davidweber/my_lib/README.md

# my_lib
My kicad library of symbols, footprints, and 3dmodels.
