davidweber/my_lib/my_3dmodels/CC0603FPNPO9BN100.step

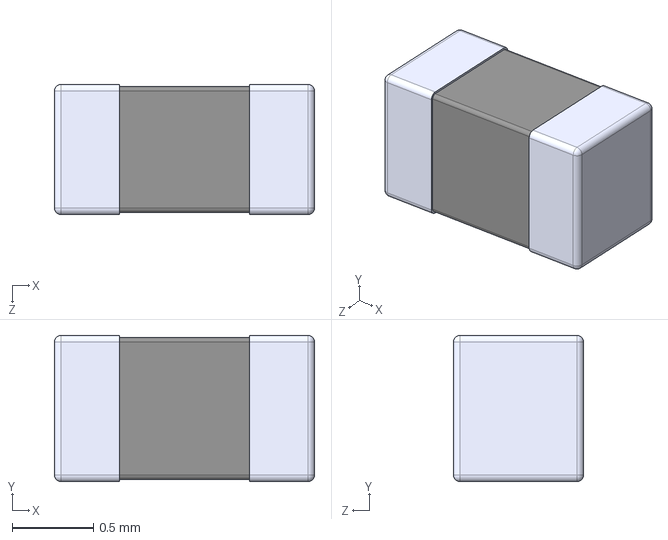
[picture p1: CAD file, 2026-08-25]
my_3dmodels/CC0603FPNPO9BN100.step
1.60 x 0.9 x 0.8 mm
