davidweber/my_lib/my_3dmodels/YC164-JR-0733RL.step

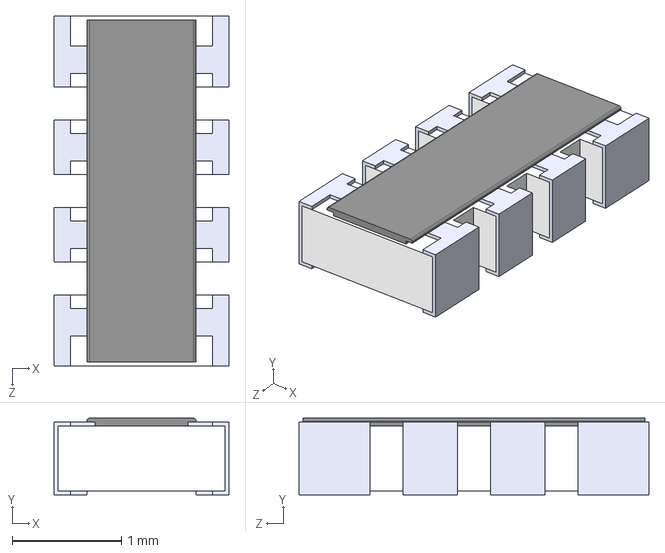
[picture p2: CAD file, 2026-08-25]
my_3dmodels/YC164-JR-0733RL.step
1.60 x 0.7 x 3.20 mm
