davidweber/my_lib/my_3dmodels/SHT40-CD1B-R3.step

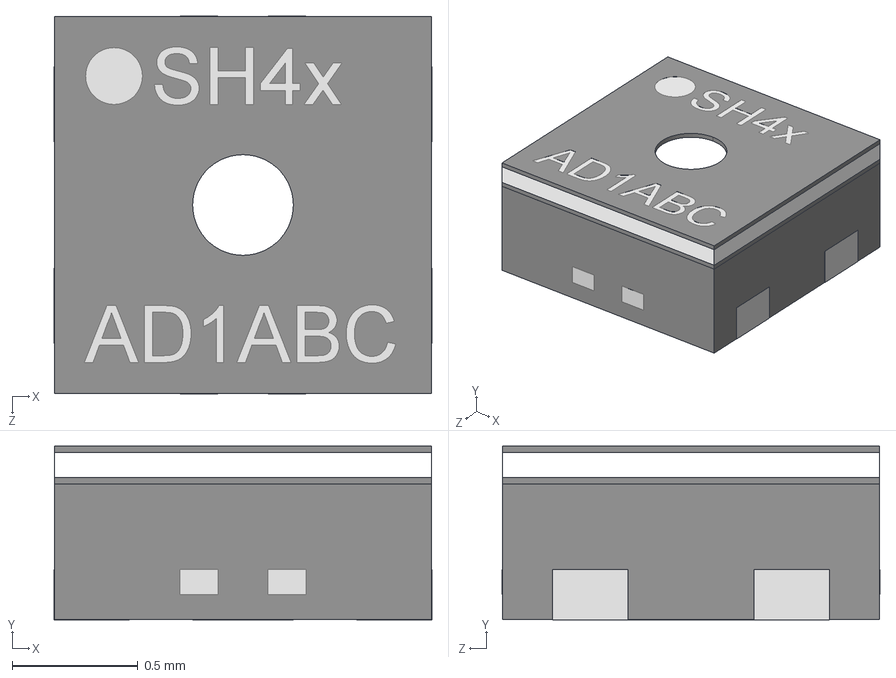
[picture p3: CAD file, 2026-08-25]
my_3dmodels/SHT40-CD1B-R3.step
1.50 x 0.691 x 1.50 mm
