davidweber/my_lib/my_3dmodels/ADS131M08IPBS.step

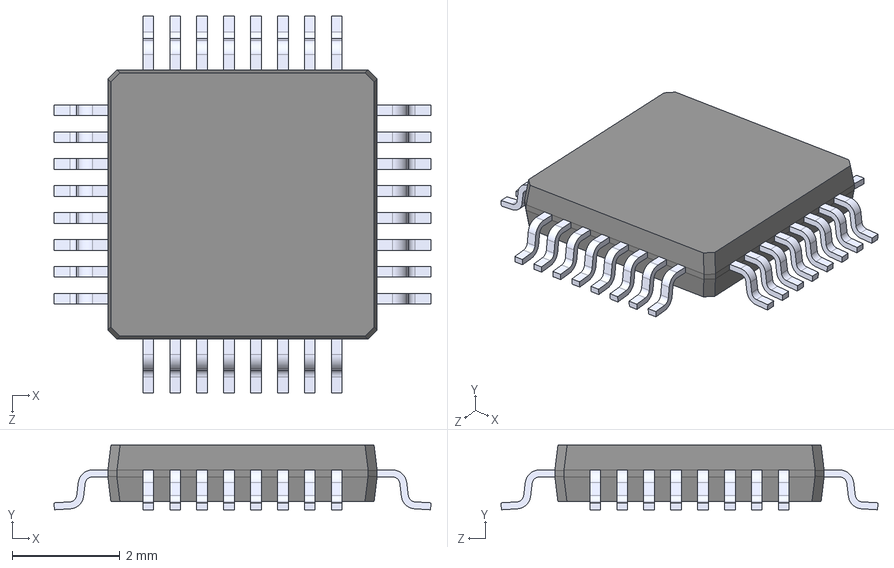
[picture p4: CAD file, 2026-08-18]
my_3dmodels/ADS131M08IPBS.step
7.00 x 1.20 x 7.00 mm
