davidweber/my_lib/my_3dmodels/ASV-16.384MHZ-EJ-T.step

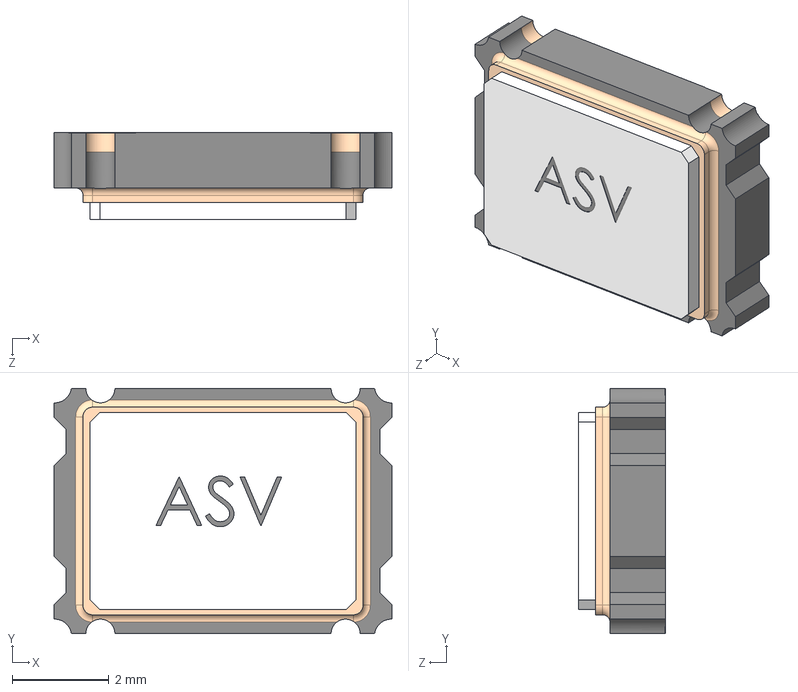
[picture p5: CAD file, 2026-08-18]
my_3dmodels/ASV-16.384MHZ-EJ-T.step
7.00 x 5.08 x 1.80 mm
