davidweber/my_lib/my_3dmodels/SN74HCS365QWBQBRQ1.step

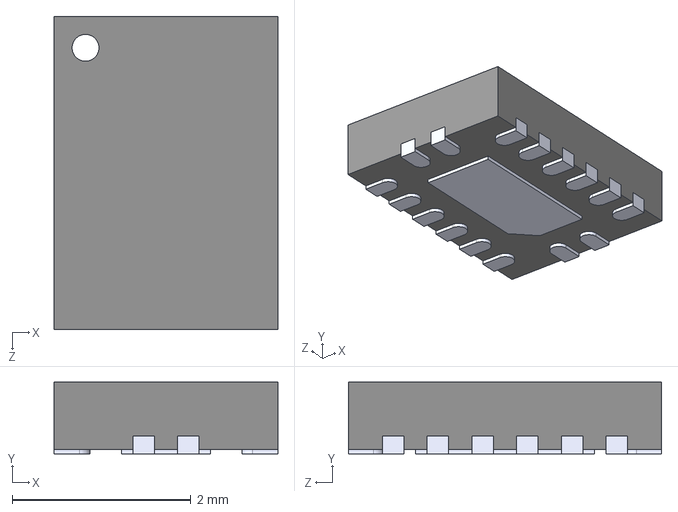
[picture p6: CAD file, 2026-08-18]
my_3dmodels/SN74HCS365QWBQBRQ1.step
2.50 x 0.8 x 3.50 mm
