davidweber/my_lib/my_3dmodels/YC164-FR-071KL.step

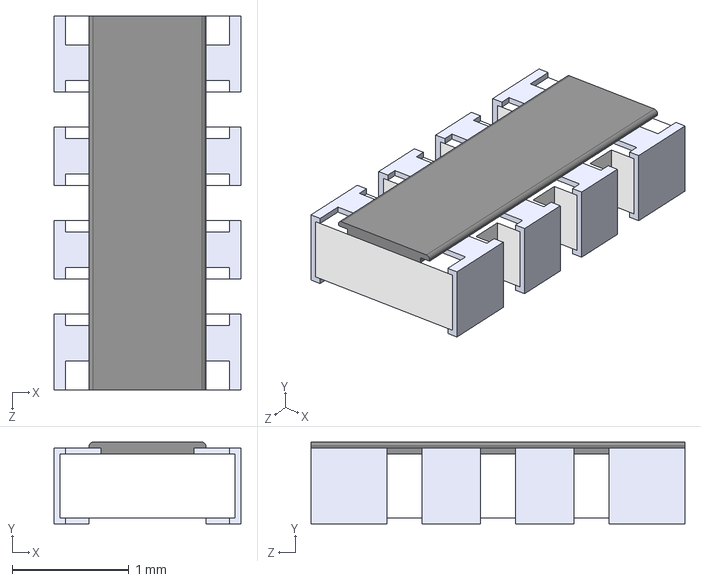
[picture p7: CAD file, 2026-08-18]
my_3dmodels/YC164-FR-071KL.step
1.60 x 0.7 x 3.20 mm
