davidweber/my_lib/my_3dmodels/ABM8-16.384MHZ-10-1-U-T.step

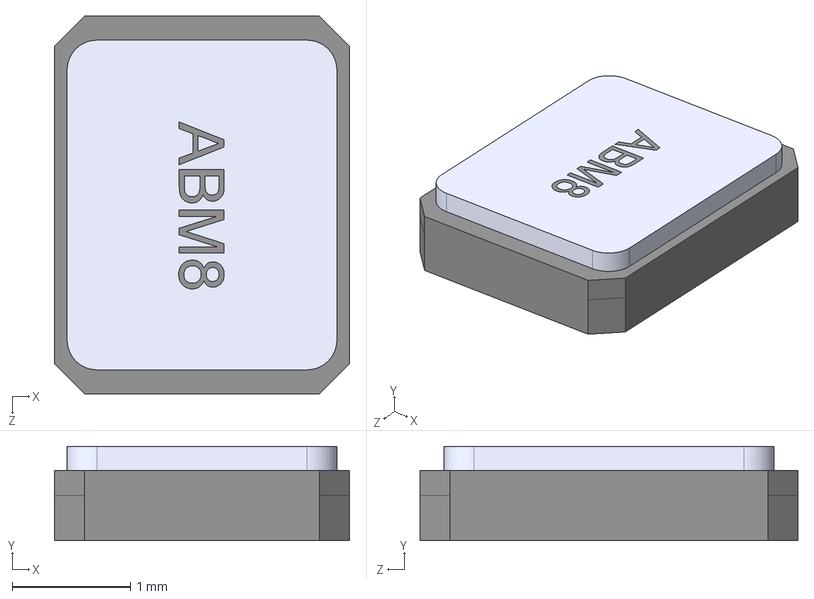
[picture p8: CAD file, 2026-08-18]
my_3dmodels/ABM8-16.384MHZ-10-1-U-T.step
2.50 x 0.8 x 3.20 mm
