davidweber/my_lib/my_3dmodels/YC124-FR-071KL.step

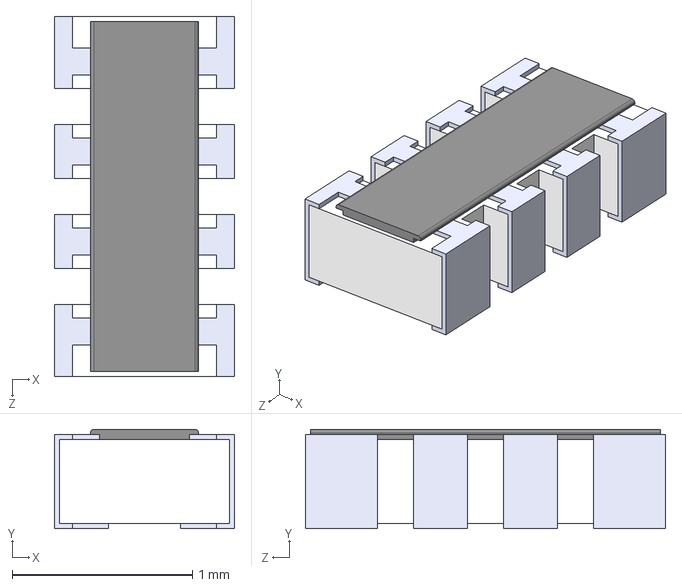
[picture p9: CAD file, 2026-08-18]
my_3dmodels/YC124-FR-071KL.step
1.00 x 0.55 x 2.00 mm
