davidweber/my_lib/my_3dmodels/ESP32-S3-MINI-1-N8.step

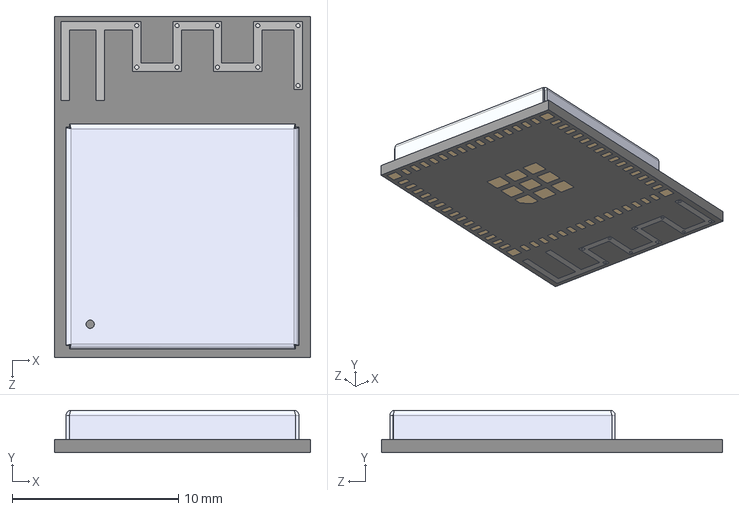
[picture p10: CAD file, 2026-05-01]
my_3dmodels/ESP32-S3-MINI-1-N8.step
15.4 x 2.55 x 20.5 mm
