davidweber/my_lib/my_3dmodels/ASDMB-50.000MHZ-XY-T.step

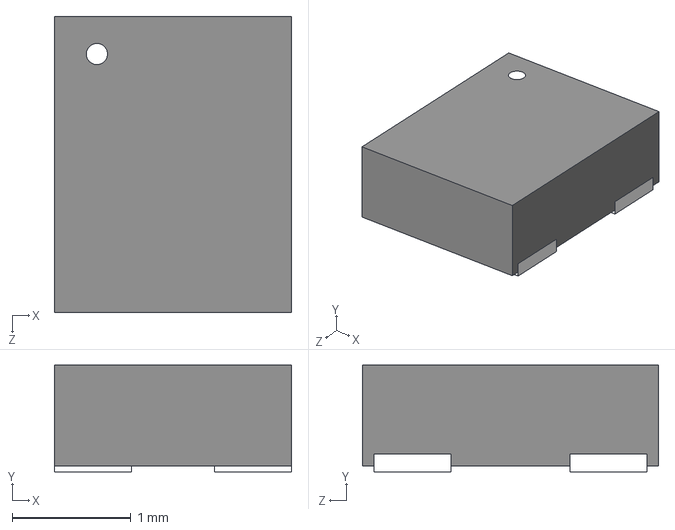
[picture p11: CAD file, 2026-04-23]
my_3dmodels/ASDMB-50.000MHZ-XY-T.step
2.00 x 0.9 x 2.50 mm
