davidweber/my_lib/my_3dmodels/L8BE-1G1T-BFH.step

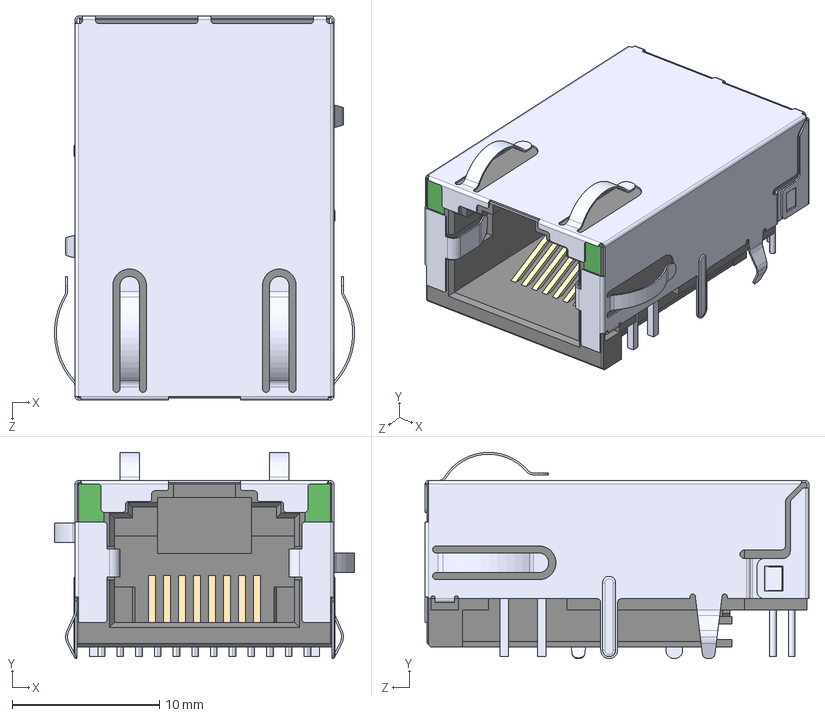
[picture p12: CAD file, 2026-04-10]
my_3dmodels/L8BE-1G1T-BFH.step
20.4 x 14.0 x 26.1 mm
