davidweber/my_lib/my_3dmodels/CONMHF1-SMD-G-T.step

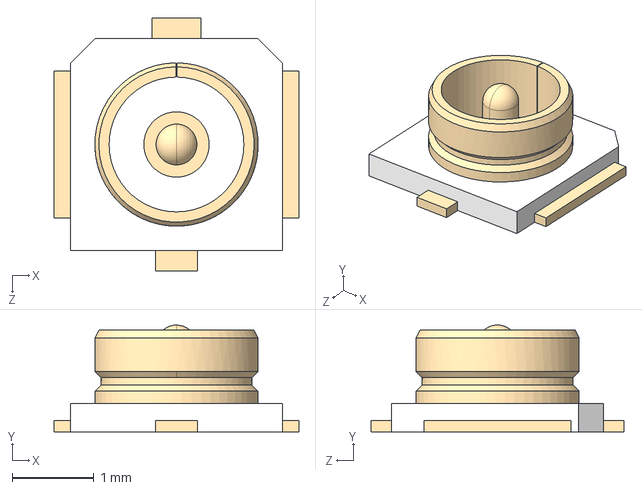
[picture p13: CAD file, 2026-04-10]
my_3dmodels/CONMHF1-SMD-G-T.step
3.00 x 1.31 x 3.10 mm
