davidweber/my_lib/my_3dmodels/MBRD660CTG.STEP

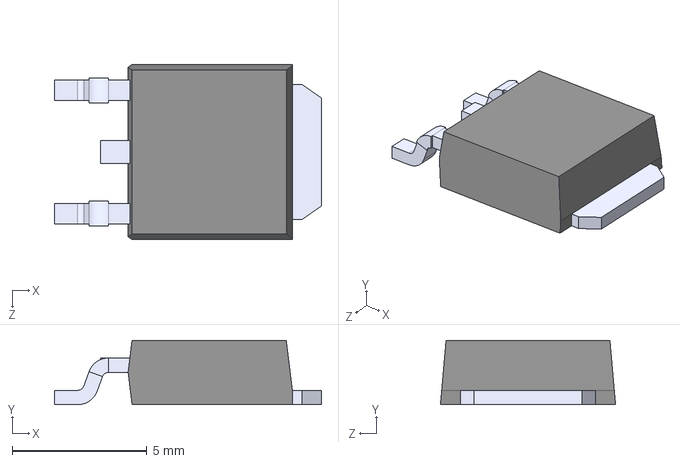
[picture p14: CAD file, 2026-03-04]
my_3dmodels/MBRD660CTG.STEP
9.91 x 2.39 x 6.50 mm
