davidweber/my_lib/my_3dmodels/TPD4E05U06DQAR.step

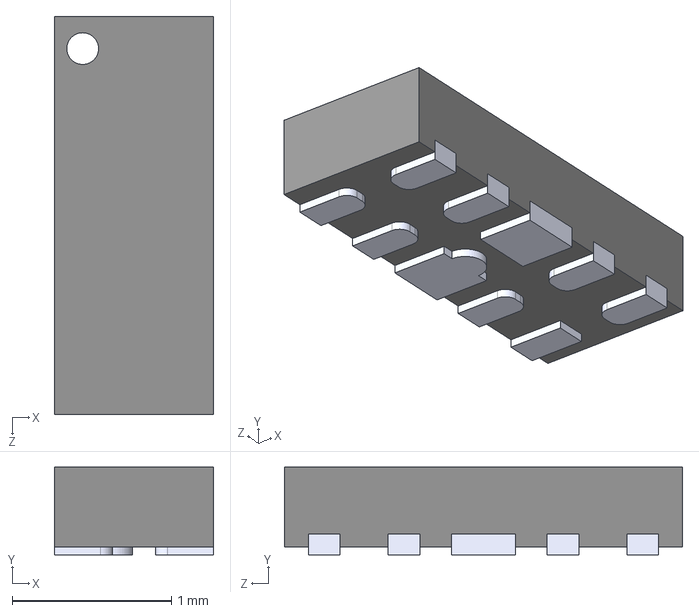
[picture p15: CAD file, 2026-02-11]
my_3dmodels/TPD4E05U06DQAR.step
1.00 x 0.55 x 2.50 mm
