davidweber/my_lib/my_3dmodels/MM8030-2610RK0.step

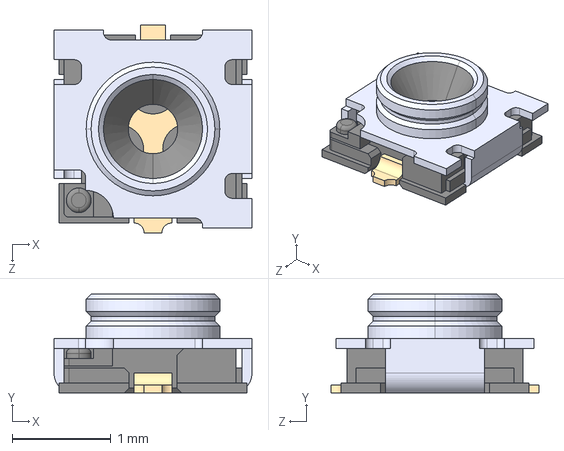
[picture p16: CAD file, 2026-02-11]
my_3dmodels/MM8030-2610RK0.step
2.00 x 1.00 x 2.10 mm
