davidweber/my_lib/my_3dmodels/SS36.step

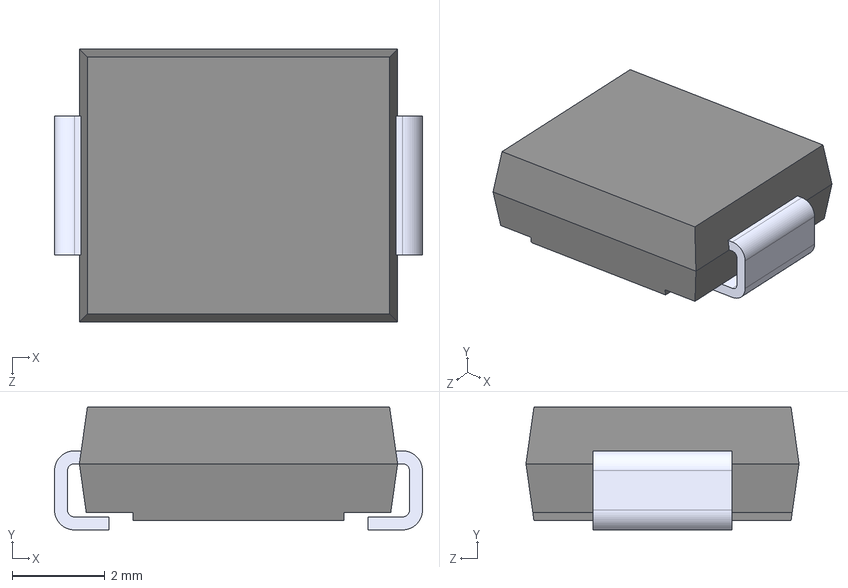
[picture p17: CAD file, 2026-02-11]
my_3dmodels/SS36.step
7.95 x 2.65 x 5.90 mm
