davidweber/my_lib/my_3dmodels/45F750E.step

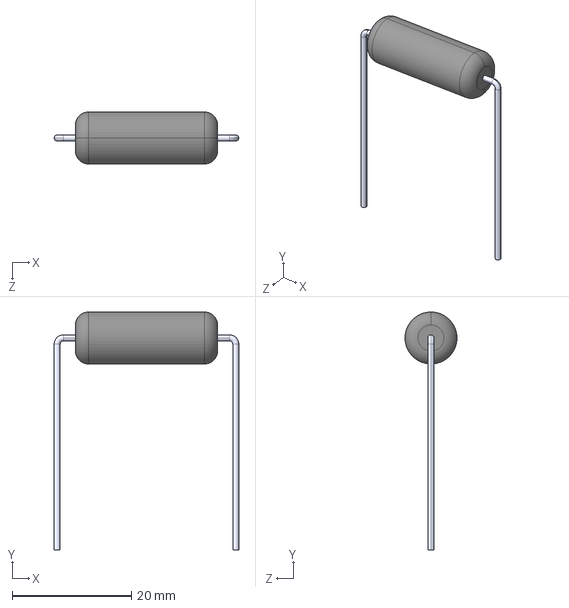
[picture p18: CAD file, 2025-10-25]
my_3dmodels/45F750E.step
30.9 x 39.8 x 8.70 mm
