davidweber/my_lib/my_3dmodels/3544.step

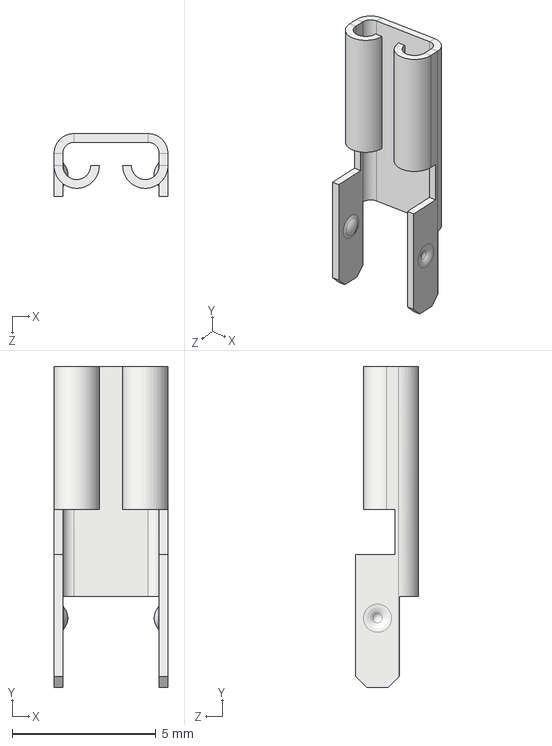
[picture p19: CAD file, 2025-10-25]
my_3dmodels/3544.step
3.96 x 11.2 x 2.18 mm
