davidweber/my_lib/my_3dmodels/B6B-PH-SM4-TB.STEP

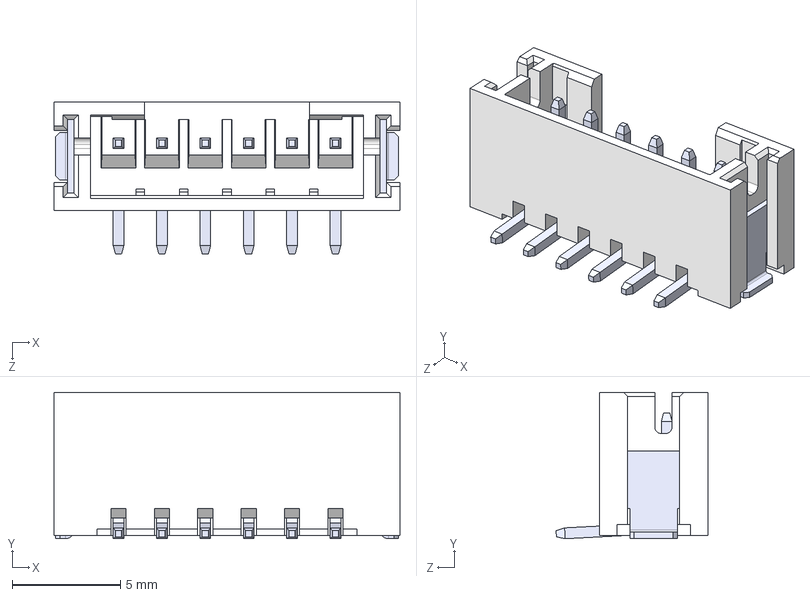
[picture p20: CAD file, 2025-10-25]
my_3dmodels/B6B-PH-SM4-TB.STEP
15.9 x 6.75 x 7.00 mm
BxB-PH-SM4 body_6
BxB-PH-SM4 tab x 2
BxB-PH-SM4 pin x 6
