davidweber/my_lib/my_3dmodels/WL-SMCW_0603.step

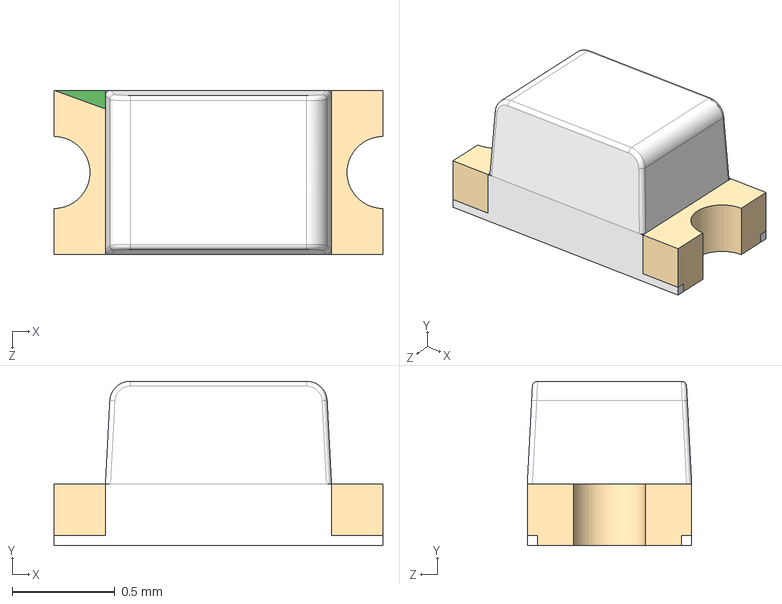
[picture p21: CAD file, 2025-08-18]
my_3dmodels/WL-SMCW_0603.step
1.60 x 0.8 x 0.8 mm
