davidweber/my_lib/my_3dmodels/MCP9700T-E_TT.STEP

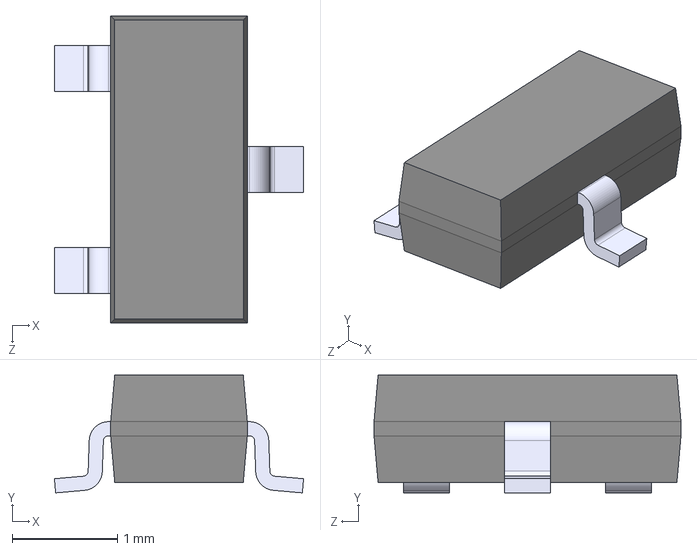
[picture p22: CAD file, 2025-08-11]
my_3dmodels/MCP9700T-E_TT.STEP
2.37 x 1.12 x 2.92 mm
