davidweber/my_lib/my_3dmodels/D2FC_F_7N_60M.step

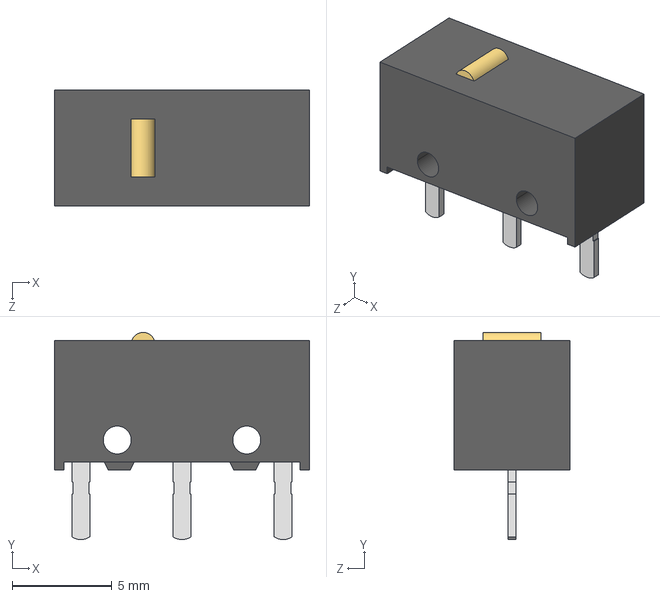
[picture p23: CAD file, 2025-07-26]
my_3dmodels/D2FC_F_7N_60M.step
12.8 x 10.4 x 5.80 mm
D2FC_F_7N_60M_BASE
D2FC_F_7N_60M_BUTTON
