davidweber/my_lib/my_3dmodels/S2B-PH-K-S_LF__SN_.step

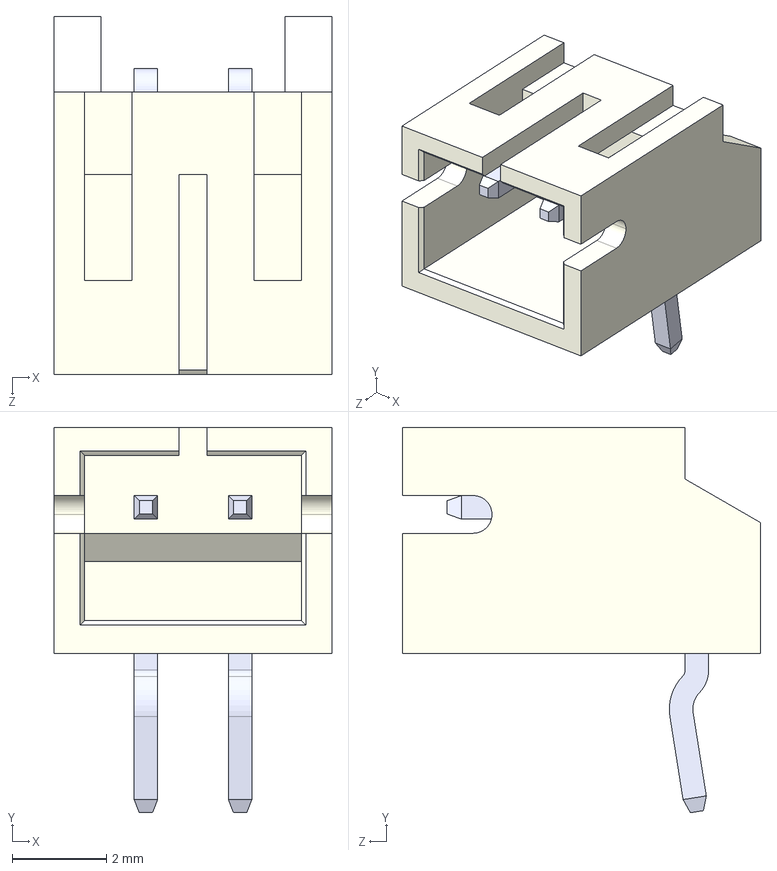
[picture p24: CAD file, 2025-07-26]
my_3dmodels/S2B-PH-K-S_LF__SN_.step
5.90 x 8.18 x 7.60 mm
