davidweber/my_lib/my_3dmodels/B6B-ZR-SM4-TF--3DModel-STEP-56544.STEP

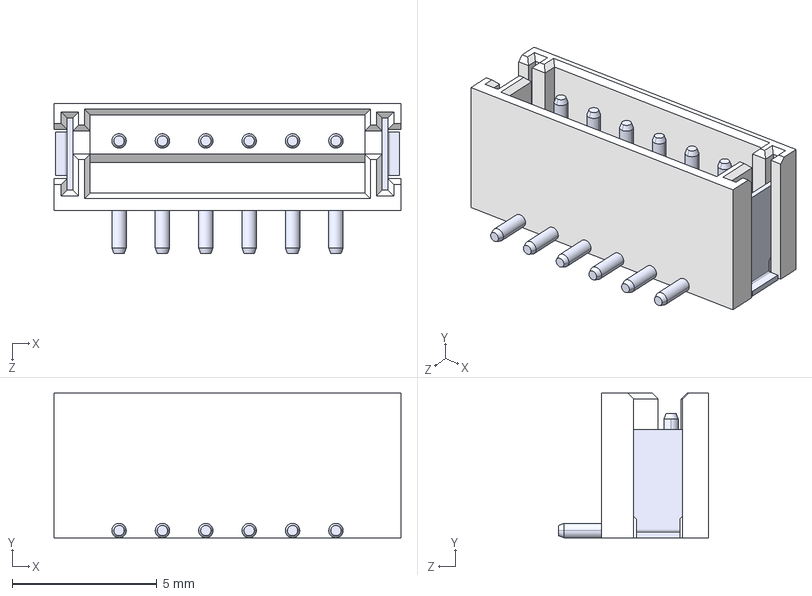
[picture p25: CAD file, 2025-07-26]
my_3dmodels/B6B-ZR-SM4-TF--3DModel-STEP-56544.STEP
12.0 x 5.00 x 5.20 mm
BxB-ZR-SM4_6
BxB-ZR-SM4 pins_6
