davidweber/my_lib/my_3dmodels/EM2-X-X-X.STEP

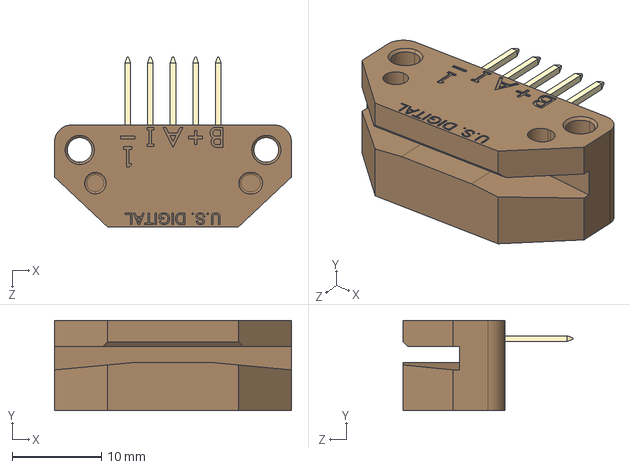
[picture p26: CAD file, 2025-07-26]
my_3dmodels/EM2-X-X-X.STEP
26.6 x 10.1 x 19.0 mm
