davidweber/my_lib/my_3dmodels/B5B-ZR-SM4-TF--3DModel-STEP-56544.STEP

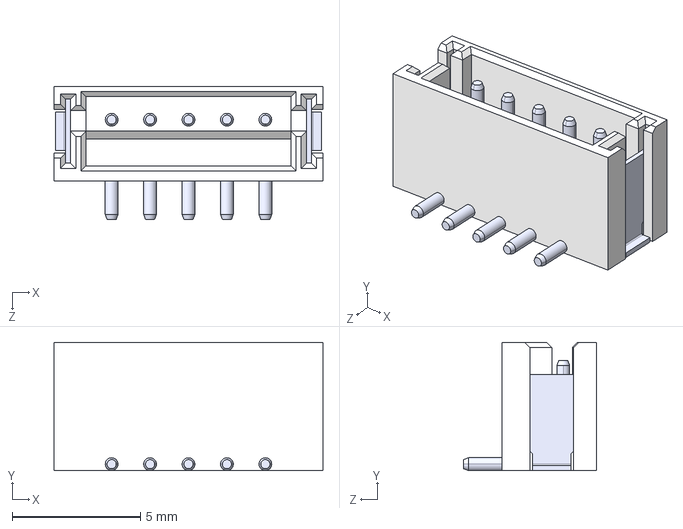
[picture p27: CAD file, 2025-07-26]
my_3dmodels/B5B-ZR-SM4-TF--3DModel-STEP-56544.STEP
10.5 x 5.00 x 5.20 mm
BxB-ZR-SM4_5
BxB-ZR-SM4 pins_5
