davidweber/my_lib/my_3dmodels/B2B-ZR-SM4-TF--3DModel-STEP-56544.STEP

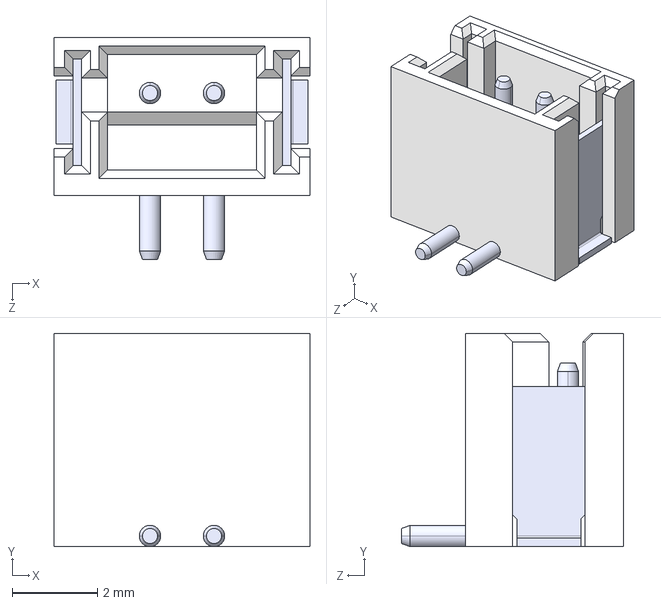
[picture p28: CAD file, 2025-07-26]
my_3dmodels/B2B-ZR-SM4-TF--3DModel-STEP-56544.STEP
6.00 x 5.00 x 5.20 mm
BxB-ZR-SM4_2
BxB-ZR-SM4 pins_2
