davidweber/my_lib/my_3dmodels/SOD523.step

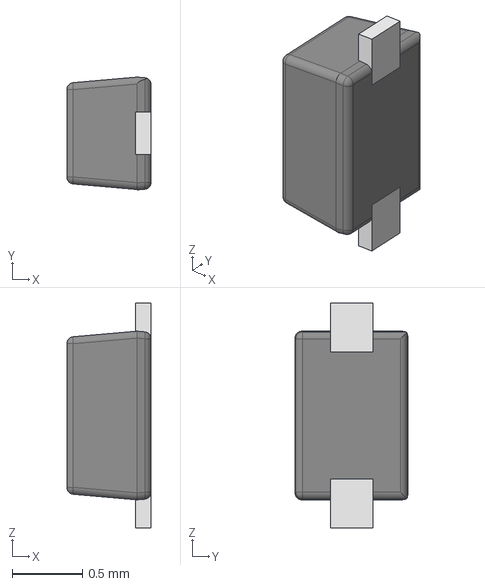
[picture p29: CAD file, 2025-03-31]
my_3dmodels/SOD523.step
0.6 x 0.803 x 1.60 mm
SOD523 LF
SOD523 compound
