davidweber/my_lib/my_3dmodels/DS01-254-S-01BE.step

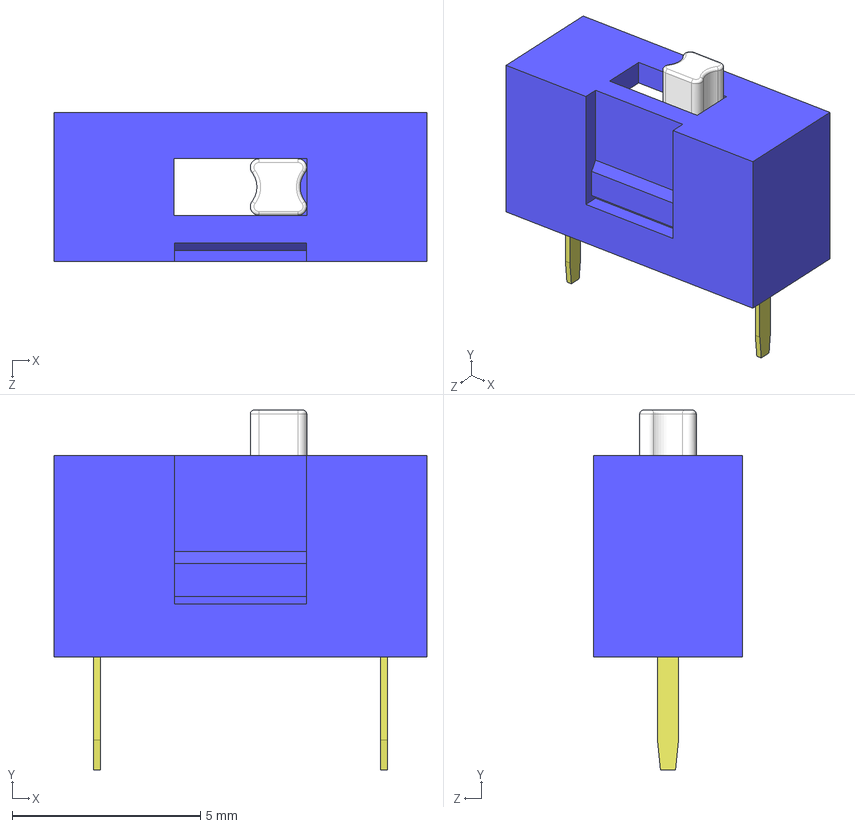
[picture p30: CAD file, 2024-12-07]
my_3dmodels/DS01-254-S-01BE.step
9.90 x 9.55 x 3.96 mm
