davidweber/my_lib/my_3dmodels/S4B-PH-K-S_LF__SN_.step

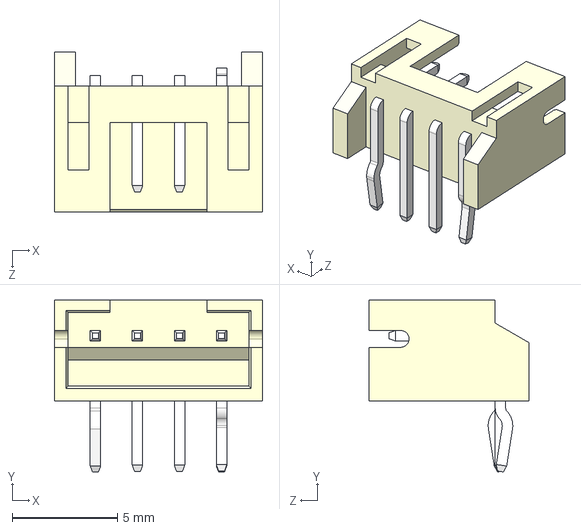
[picture p31: CAD file, 2024-11-26]
my_3dmodels/S4B-PH-K-S_LF__SN_.step
9.90 x 8.18 x 7.60 mm
