davidweber/my_lib/my_3dmodels/TFM-110-02-L-D-A-K-TR.step

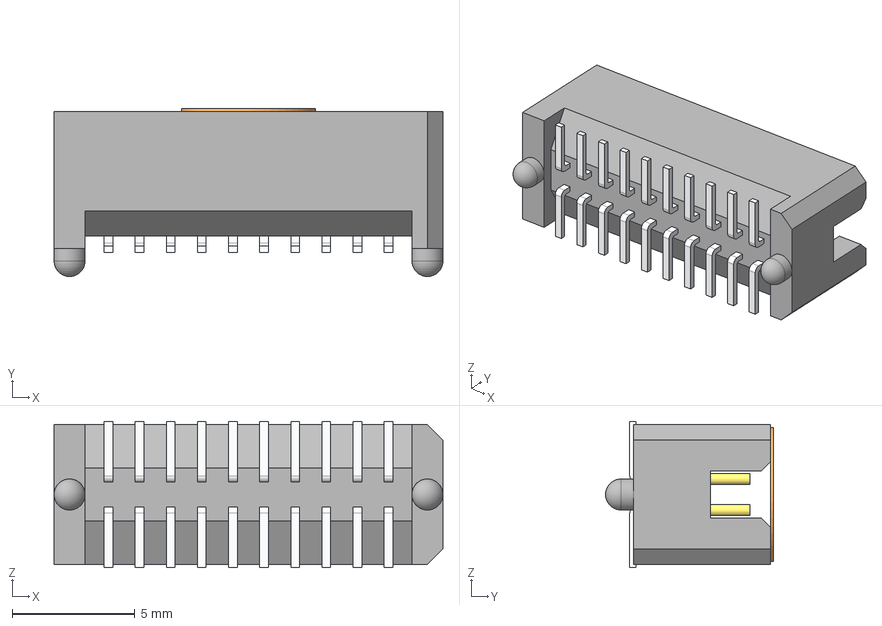
[picture p32: CAD file, 2024-11-12]
my_3dmodels/TFM-110-02-L-D-A-K-TR.step
15.9 x 6.86 x 5.97 mm
TFM-110-02-L-D-A_terminal
TFM-110-02-L-D-L_pins
TFM-110-02-L-D-L-2_pins
TFM-K_polyamide_pick
