davidweber/my_lib/my_3dmodels/RT9080-33GJ5.step

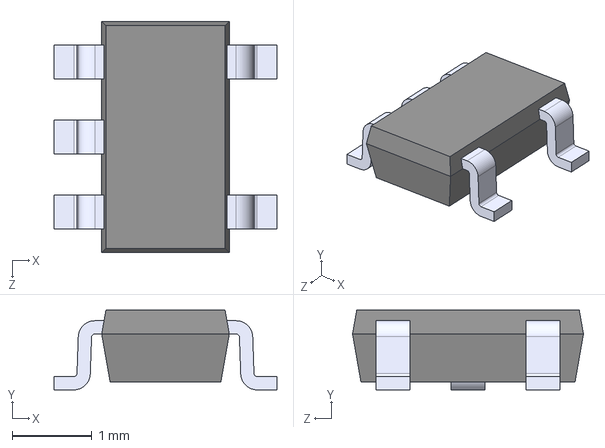
[picture p33: CAD file, 2024-11-12]
my_3dmodels/RT9080-33GJ5.step
2.80 x 1.00 x 2.90 mm
