davidweber/my_lib/my_3dmodels/SML-LXT0805IW-TR.step

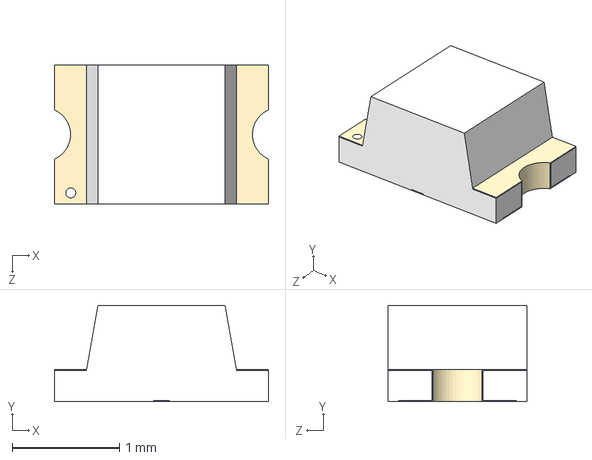
[picture p34: CAD file, 2024-11-12]
my_3dmodels/SML-LXT0805IW-TR.step
2.00 x 0.9 x 1.30 mm
