davidweber/my_lib/my_3dmodels/CUI_DEVICES_CMA-4544PF-W.step

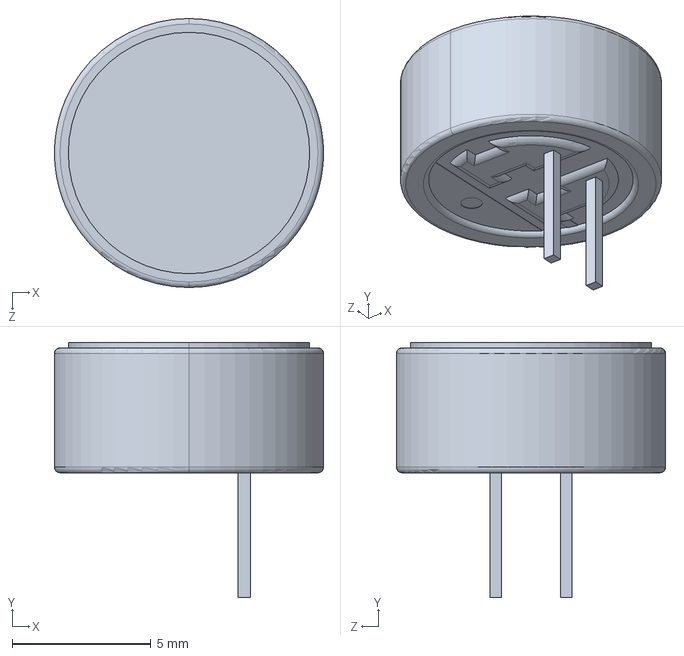
[picture p35: CAD file, 2024-11-12]
my_3dmodels/CUI_DEVICES_CMA-4544PF-W.step
9.70 x 9.20 x 9.70 mm
