davidweber/my_lib/my_3dmodels/smdCrystal.step

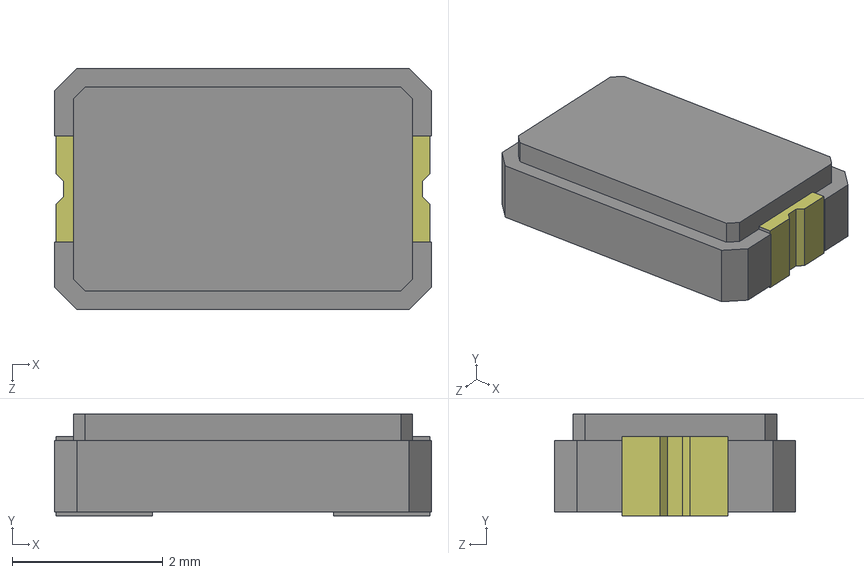
[picture p36: CAD file, 2024-11-12]
my_3dmodels/smdCrystal.step
5.00 x 1.35 x 3.20 mm
