davidweber/my_lib/my_3dmodels/PTS810.stp

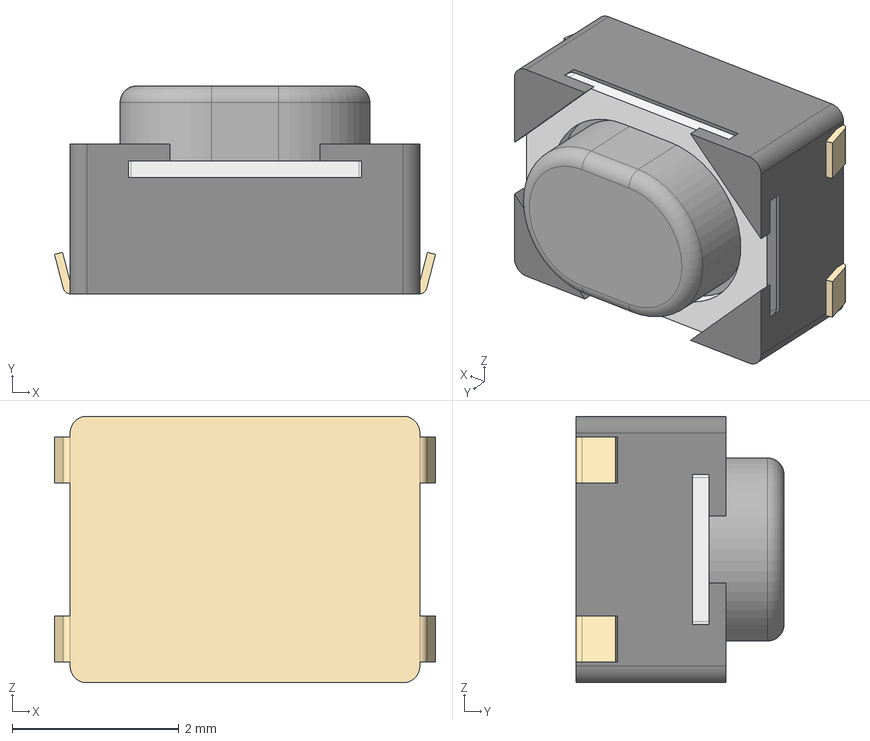
[picture p38: CAD file, 2024-11-12]
my_3dmodels/PTS810.stp
4.58 x 2.50 x 3.20 mm
