davidweber/my_lib/my_3dmodels/SAMTEC-LS2-120-01-X-D.step

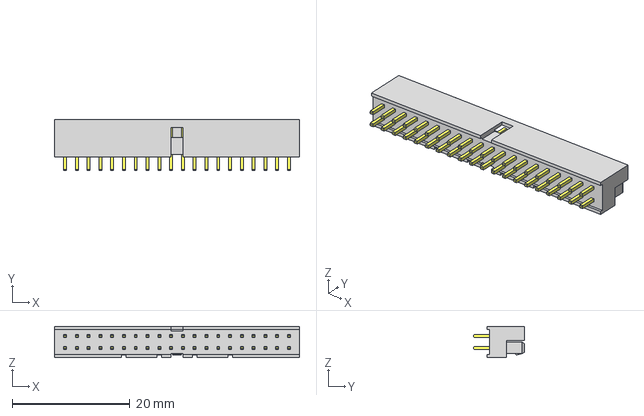
[picture p39: CAD file, 2024-11-12]
my_3dmodels/SAMTEC-LS2-120-01-X-D.step
41.5 x 8.64 x 5.27 mm
LS2-120-01-D_strip
T-1S13-20-01-D
