davidweber/my_lib/my_3dmodels/ERM5-020-02.0-L-DV-TR.step

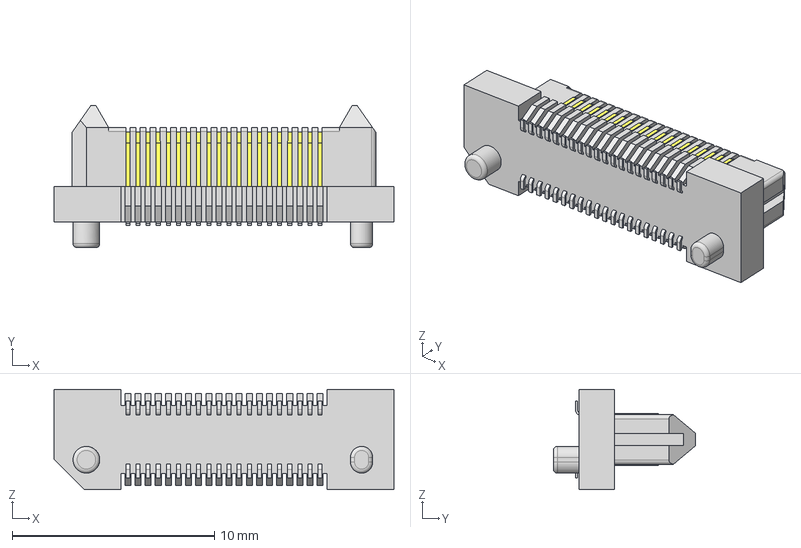
[picture p40: CAD file, 2024-11-12]
my_3dmodels/ERM5-020-02.0-L-DV-TR.step
16.8 x 7.04 x 4.95 mm
ERM5-020-02.0-DV_header
T-1M59-020-02.0
T-1M59-020-02.02
