davidweber/my_lib/my_3dmodels/xson-4.step

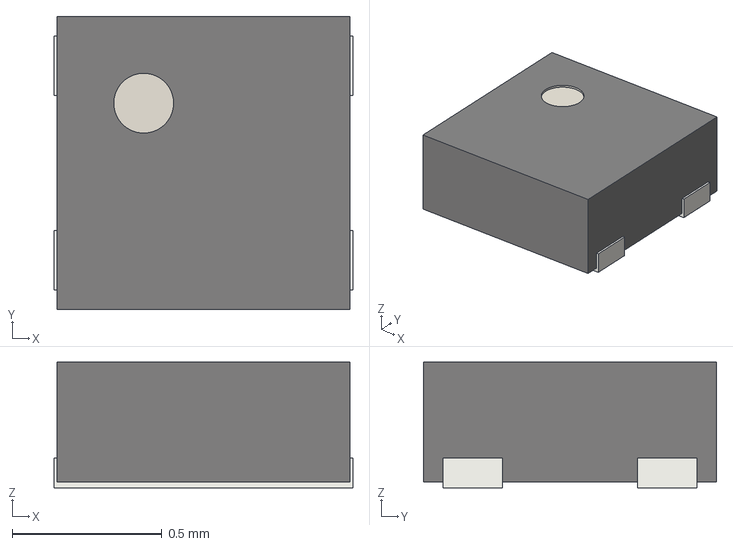
[picture p41: CAD file, 2024-11-12]
my_3dmodels/xson-4.step
1.00 x 0.98 x 0.42 mm
