davidweber/my_lib/my_3dmodels/1.8in TFT (Without Glass)- Tucked Cable.stp

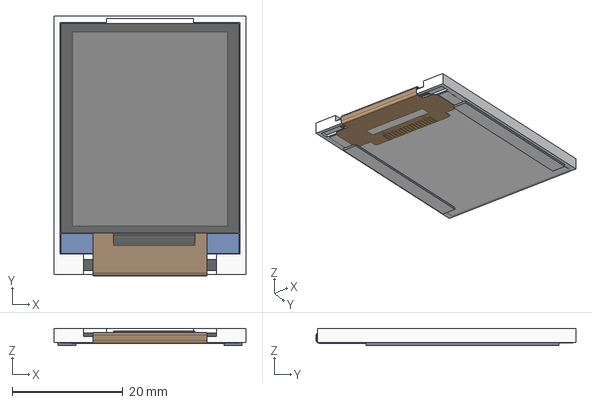
[picture p42: CAD file, 2024-11-12]
my_3dmodels/1.8in TFT (Without Glass)- Tucked Cable.stp
34.7 x 46.9 x 3.07 mm
