davidweber/my_lib/my_3dmodels/NX3L4051PW_118.step

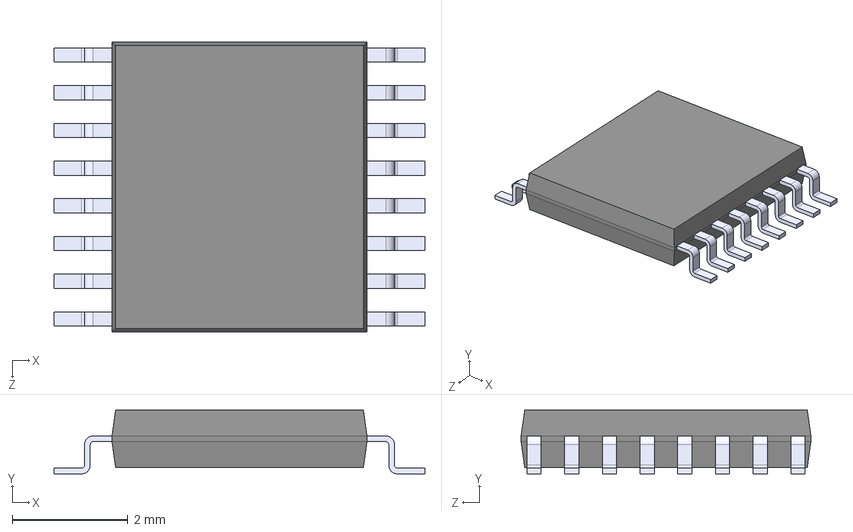
[picture p43: CAD file, 2024-11-12]
my_3dmodels/NX3L4051PW_118.step
6.40 x 1.10 x 5.00 mm
