davidweber/my_lib/my_3dmodels/BC020-04-A-0110-0160-L-G.step

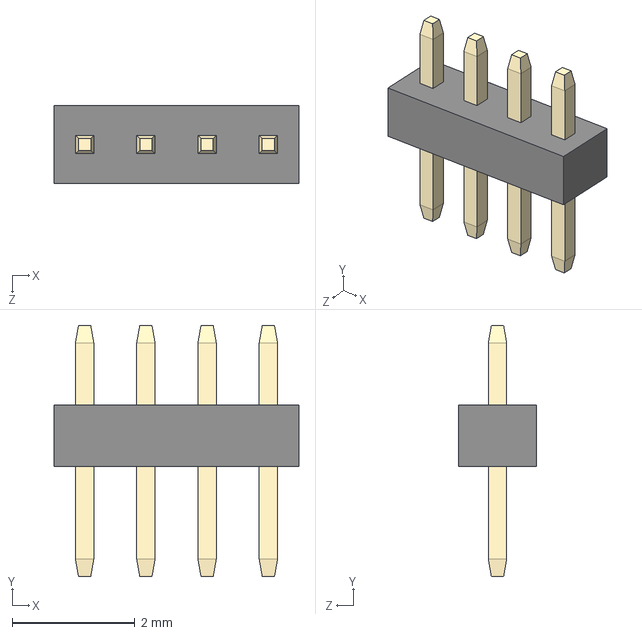
[picture p44: CAD file, 2024-11-12]
my_3dmodels/BC020-04-A-0110-0160-L-G.step
4.00 x 4.10 x 1.27 mm
Body^BC020-xxxx
pin^BC020-xxxx x 4
