davidweber/my_lib/my_3dmodels/CUI_DEVICES_TS02-66-60-BK-160-SCR-D.step

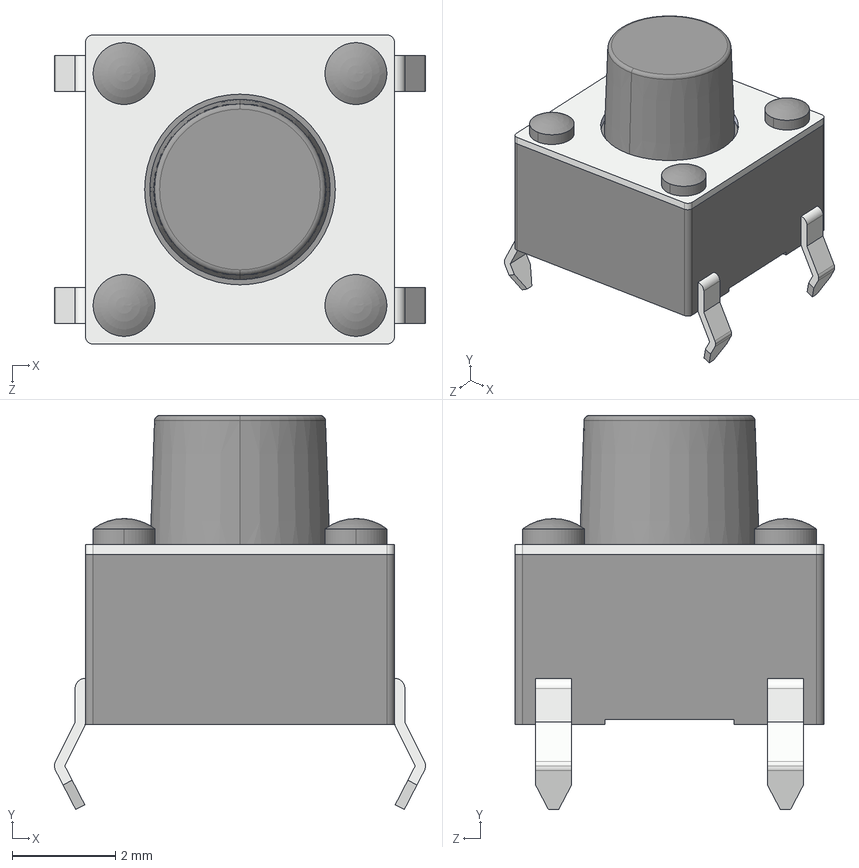
[picture p45: CAD file, 2024-11-12]
my_3dmodels/CUI_DEVICES_TS02-66-60-BK-160-SCR-D.step
7.20 x 7.65 x 6.00 mm
