davidweber/my_lib/my_3dmodels/OPA2354AQDGKRQ1.step

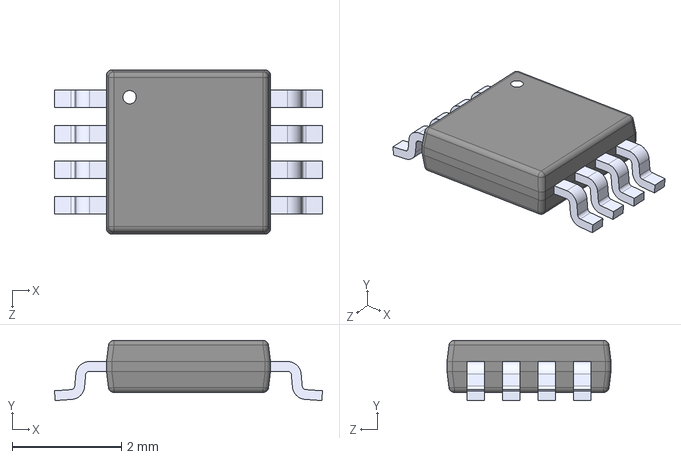
[picture p46: CAD file, 2024-11-12]
my_3dmodels/OPA2354AQDGKRQ1.step
4.90 x 1.10 x 3.00 mm
