davidweber/my_lib/my_3dmodels/FTSH-103-04-L-D.step

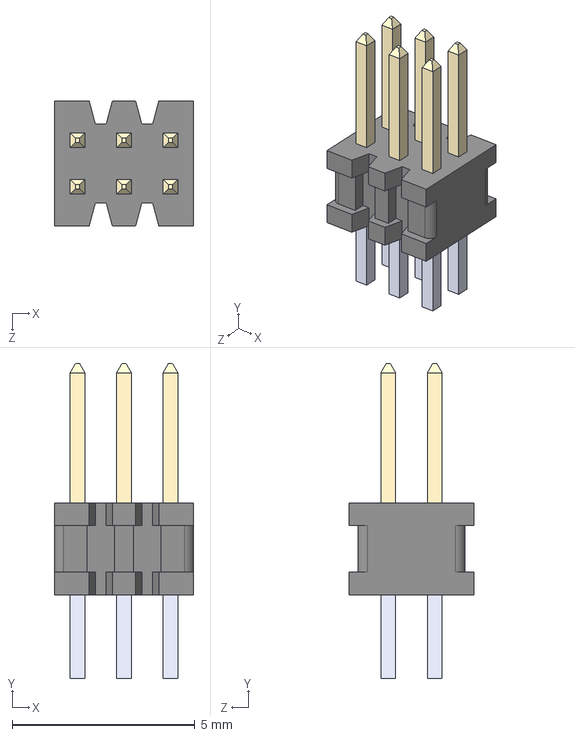
[picture p47: CAD file, 2024-11-12]
my_3dmodels/FTSH-103-04-L-D.step
3.81 x 8.61 x 3.43 mm
