davidweber/my_lib/my_3dmodels/ASFL1-25.000MHZ-L-T.step

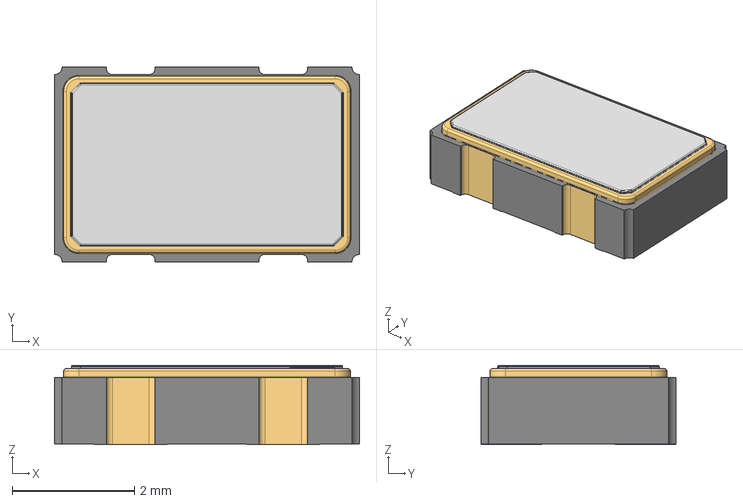
[picture p48: CAD file, 2024-11-12]
my_3dmodels/ASFL1-25.000MHZ-L-T.step
5.00 x 3.20 x 1.30 mm
