davidweber/my_lib/my_3dmodels/TSOT-23-5_RIT.step

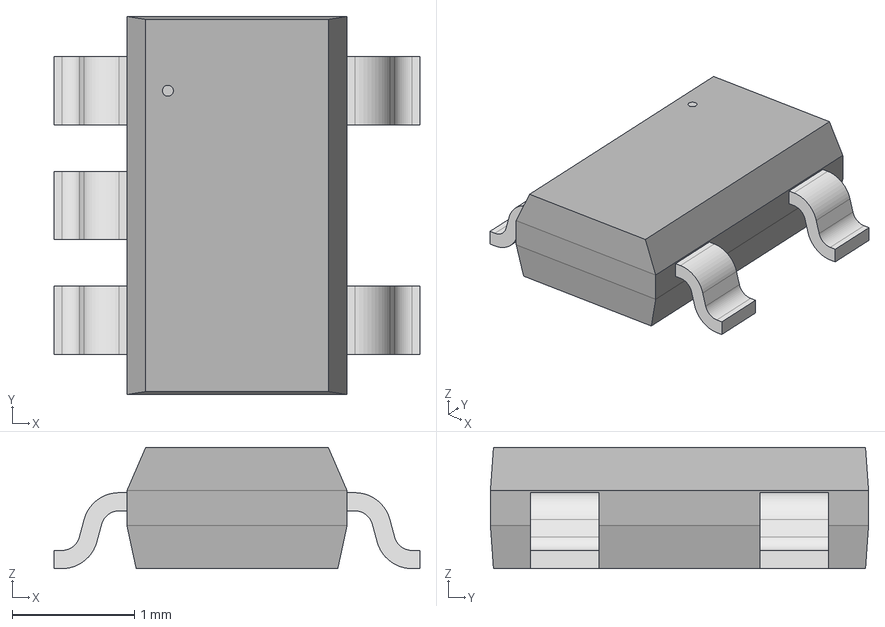
[picture p49: CAD file, 2024-11-12]
my_3dmodels/TSOT-23-5_RIT.step
3.00 x 3.10 x 0.993 mm
