davidweber/my_lib/my_3dmodels/74LVC125APW_AUJ.step

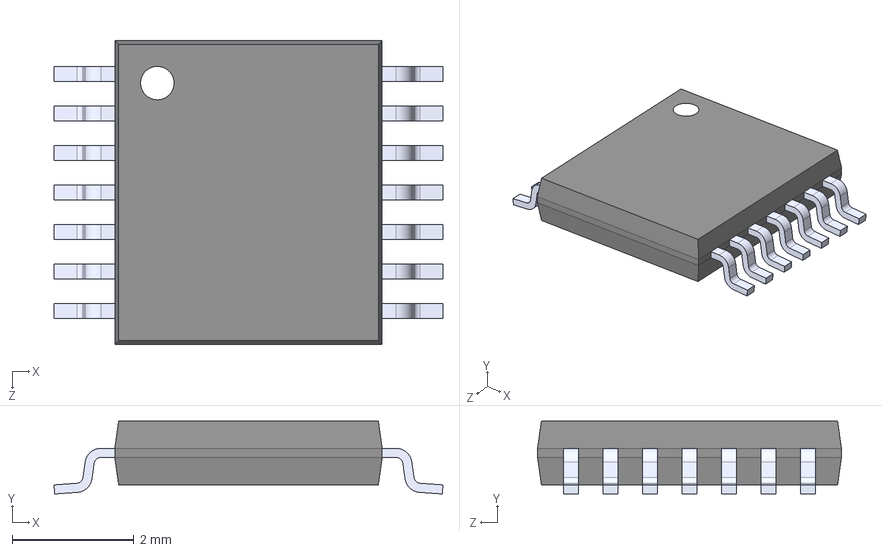
[picture p50: CAD file, 2024-11-12]
my_3dmodels/74LVC125APW_AUJ.step
6.40 x 1.20 x 5.00 mm
