davidweber/my_lib/my_3dmodels/KMR221GLFS.step

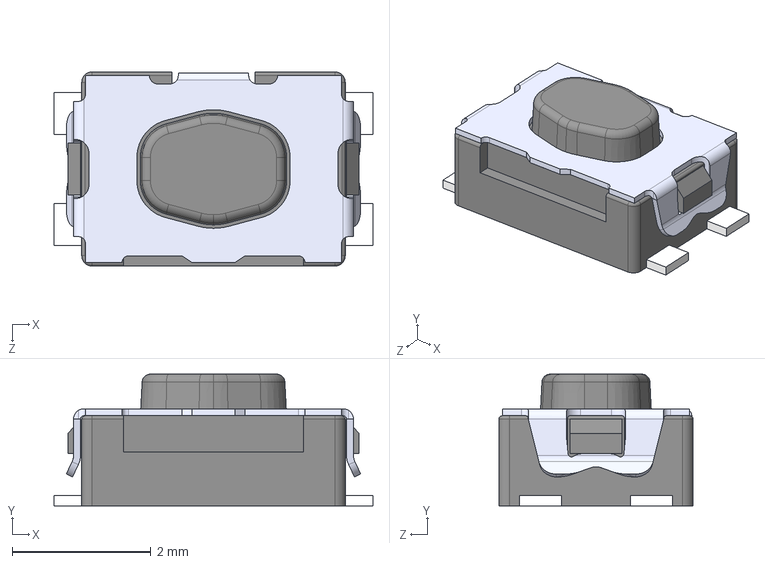
[picture p51: CAD file, 2024-11-12]
my_3dmodels/KMR221GLFS.step
4.60 x 1.90 x 2.80 mm
