davidweber/my_lib/my_3dmodels/3228_reverse_mount_led.step

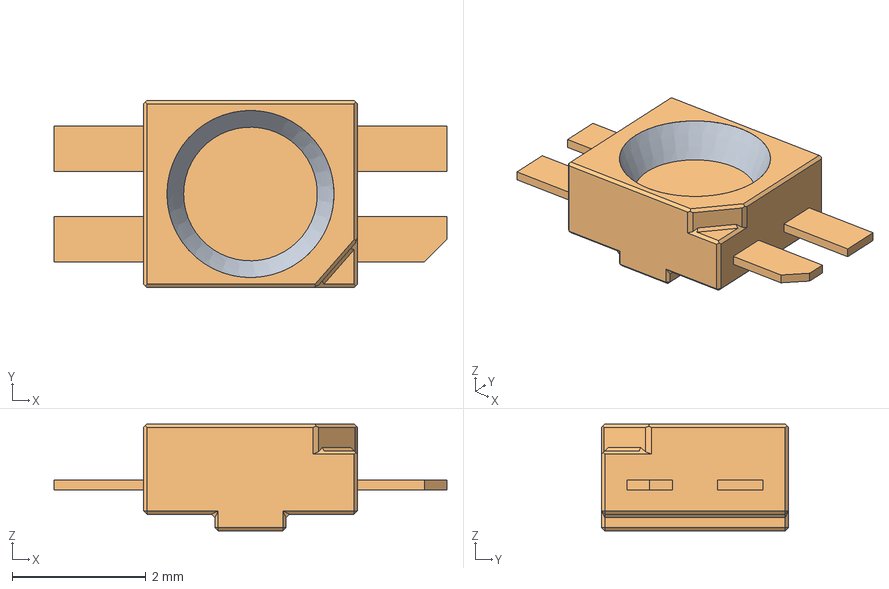
[picture p52: CAD file, 2024-11-12]
my_3dmodels/3228_reverse_mount_led.step
5.88 x 2.80 x 1.60 mm
