davidweber/my_lib/my_3dmodels/TP_SMD_S1751-46.step

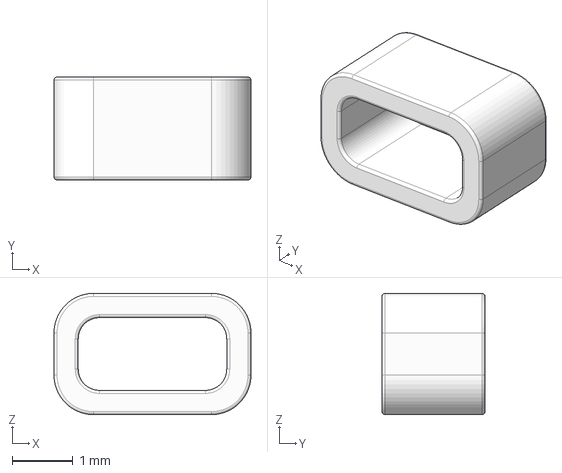
[picture p53: CAD file, 2024-11-12]
my_3dmodels/TP_SMD_S1751-46.step
3.25 x 1.70 x 2.00 mm
