davidweber/my_lib/my_3dmodels/LAN8742A-CZ-TR.step

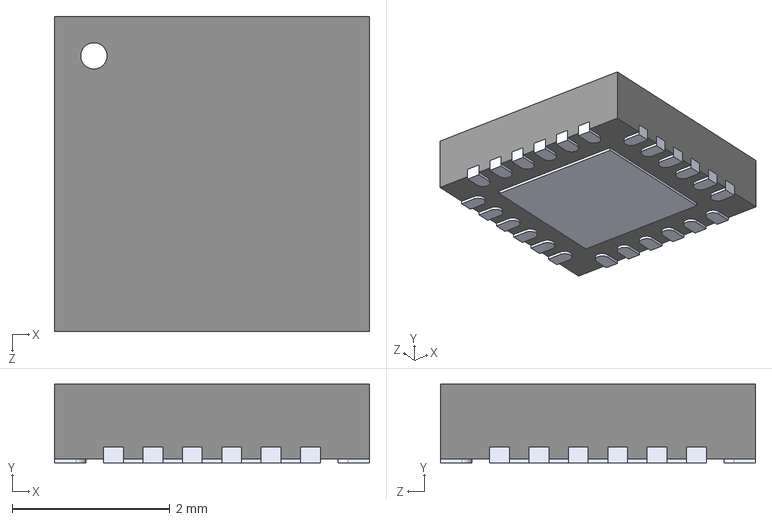
[picture p54: CAD file, 2024-11-12]
my_3dmodels/LAN8742A-CZ-TR.step
4.00 x 1.00 x 4.00 mm
