davidweber/my_lib/my_3dmodels/T-PBGA-24_6.0x8.0mm_Layout5x5_P1.0mm.step

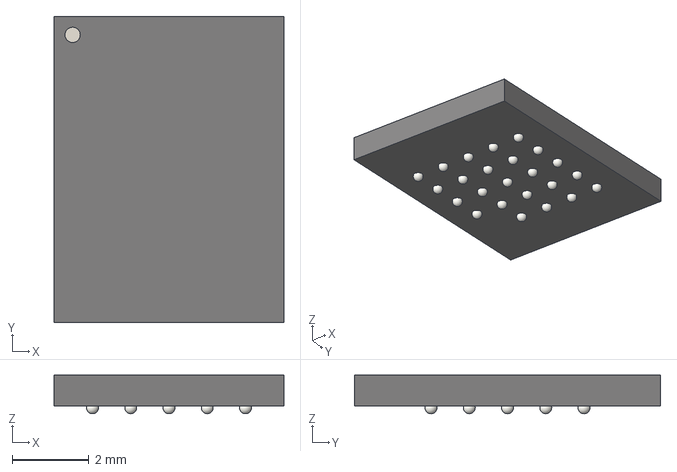
[picture p55: CAD file, 2024-11-12]
my_3dmodels/T-PBGA-24_6.0x8.0mm_Layout5x5_P1.0mm.step
6.00 x 8.00 x 1.01 mm
