davidweber/my_lib/my_3dmodels/ESP32-C6-MINI-1-N4.step

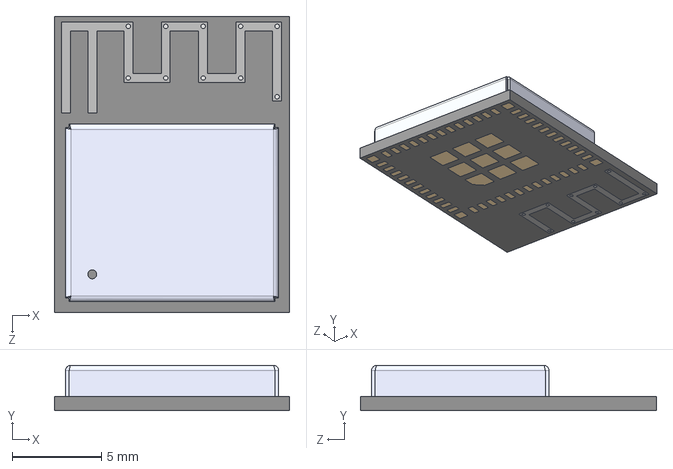
[picture p56: CAD file, 2024-11-12]
my_3dmodels/ESP32-C6-MINI-1-N4.step
13.2 x 2.55 x 16.6 mm
