davidweber/my_lib/my_3dmodels/USB-C-C168688.step

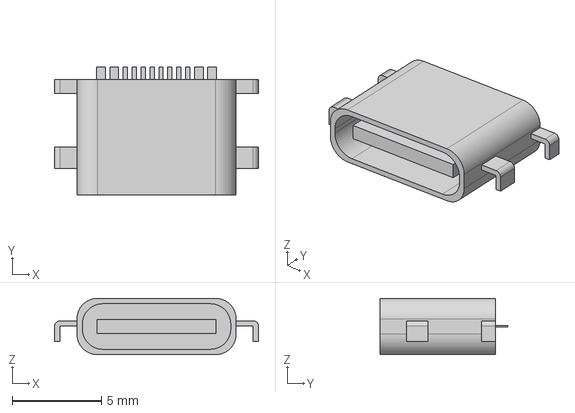
[picture p57: CAD file, 2024-11-12]
my_3dmodels/USB-C-C168688.step
11.5 x 7.20 x 3.16 mm
