davidweber/my_lib/my_3dmodels/RGY0020A.stp

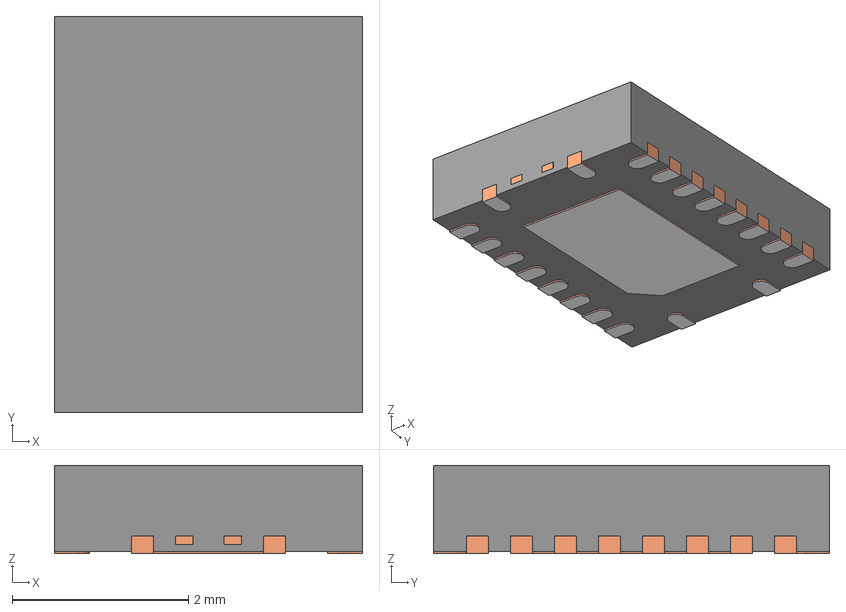
[picture p58: CAD file, 2024-11-12]
my_3dmodels/RGY0020A.stp
3.50 x 4.50 x 1.00 mm
BODY-QFN
FRAME-RGY0020A
PIN1-ID
