davidweber/my_lib/my_3dmodels/ERM5-030-02.0-S-DV-TR.step

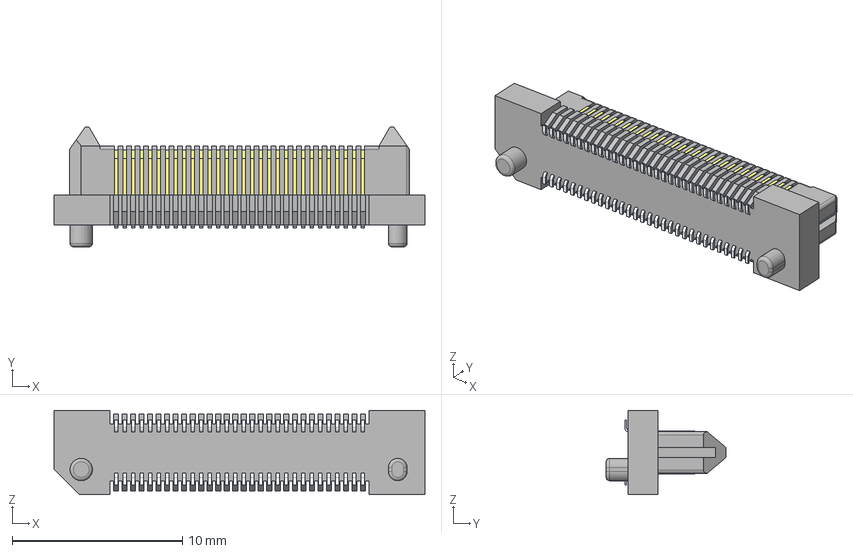
[picture p59: CAD file, 2024-11-12]
my_3dmodels/ERM5-030-02.0-S-DV-TR.step
21.8 x 7.04 x 4.95 mm
ERM5-030-02.0-DV_header
T-1M59-030-02.0
T-1M59-030-02.02
