davidweber/my_lib/my_3dmodels/GRM1555C1E471JA01D.step

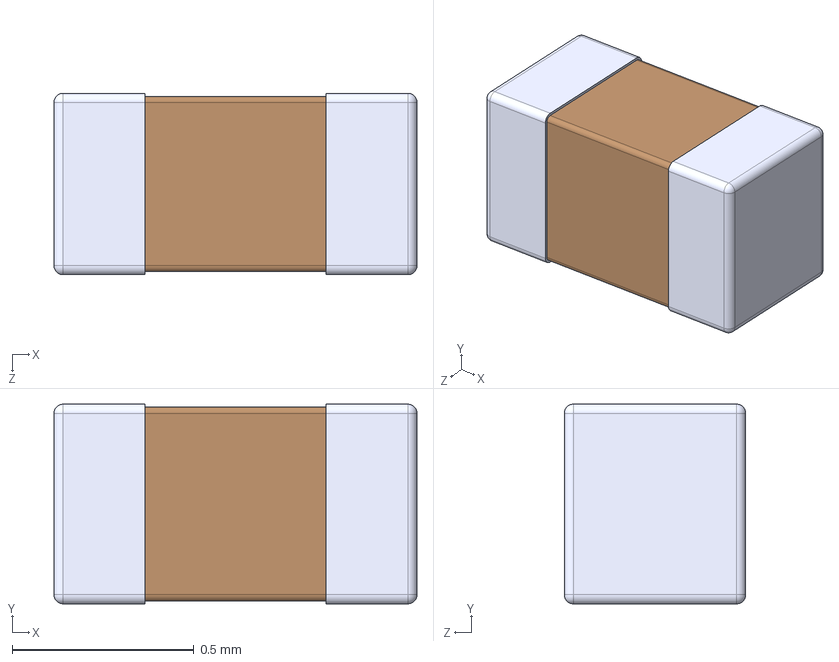
[picture p60: CAD file, 2024-11-12]
my_3dmodels/GRM1555C1E471JA01D.step
1.00 x 0.55 x 0.5 mm
