davidweber/my_lib/my_3dmodels/holyiot_18010_nRF52840.step

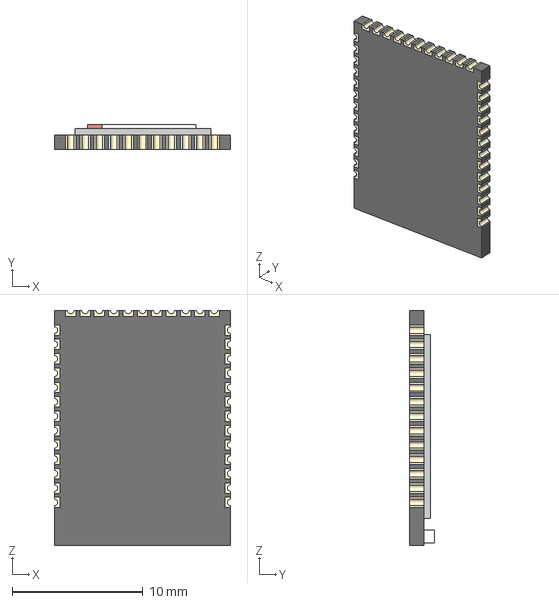
[picture p61: CAD file, 2024-11-12]
my_3dmodels/holyiot_18010_nRF52840.step
13.5 x 1.92 x 18.0 mm
