davidweber/my_lib/my_3dmodels/1267.step

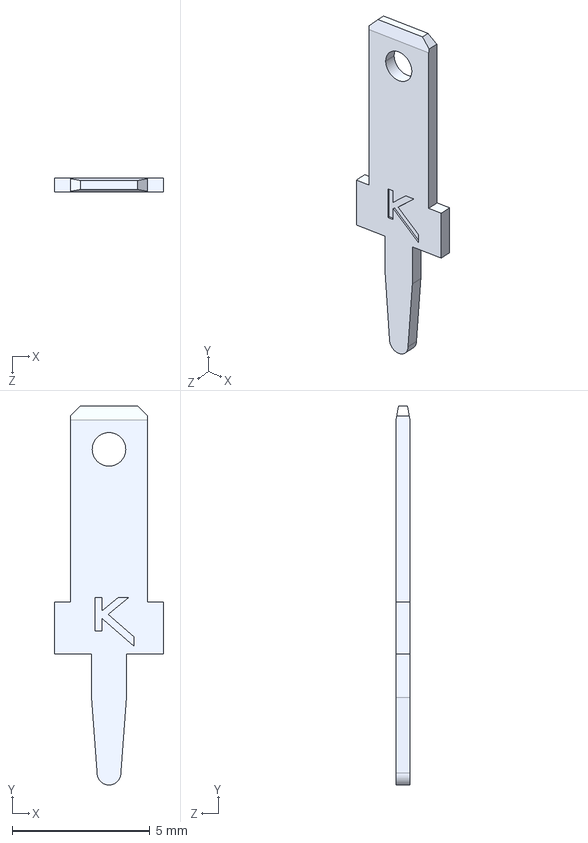
[picture p62: CAD file, 2024-11-12]
my_3dmodels/1267.step
3.96 x 13.8 x 0.508 mm
