davidweber/my_lib/my_3dmodels/TYPE-C-31-M-14.step

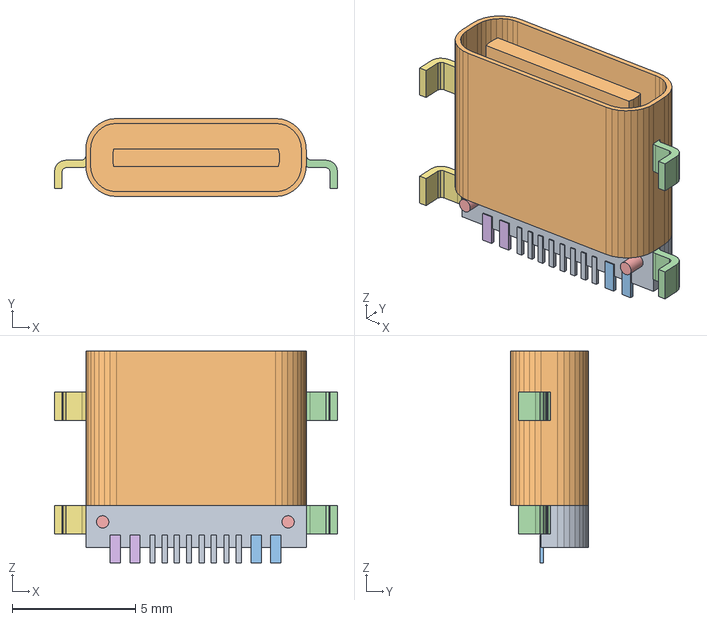
[picture p63: CAD file, 2024-11-12]
my_3dmodels/TYPE-C-31-M-14.step
11.5 x 3.16 x 8.58 mm
