davidweber/my_lib/my_3dmodels/C3216X7R2A104K160AA.step

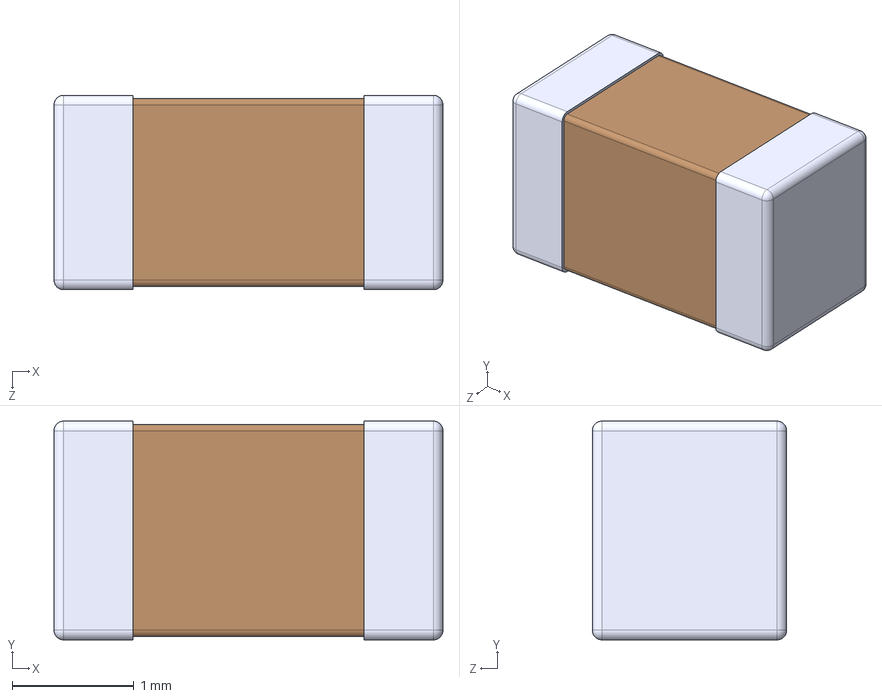
[picture p64: CAD file, 2024-11-12]
my_3dmodels/C3216X7R2A104K160AA.step
3.20 x 1.80 x 1.60 mm
