davidweber/my_lib/my_3dmodels/GPS6MV2.step

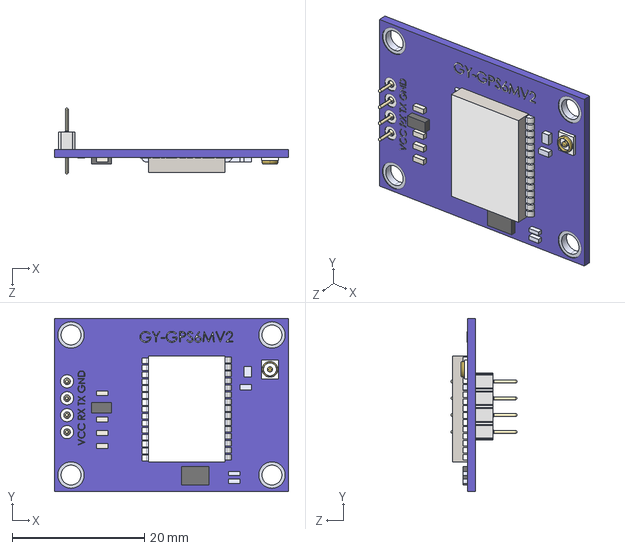
[picture p65: CAD file, 2024-11-12]
my_3dmodels/GPS6MV2.step
35.4 x 26.2 x 10.0 mm
