davidweber/my_lib/my_3dmodels/FTSH-110-01-F-D-RA.step

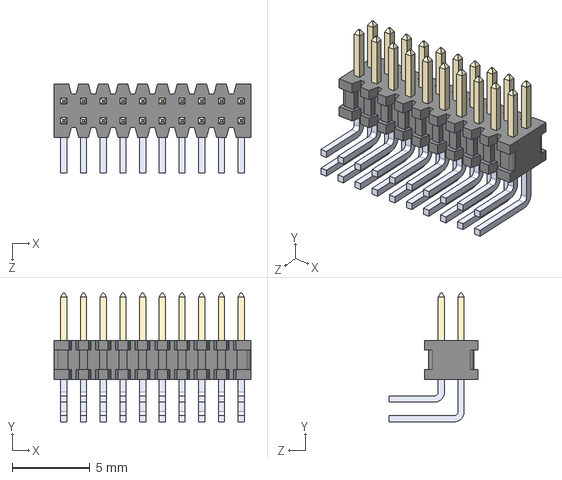
[picture p66: CAD file, 2024-11-12]
my_3dmodels/FTSH-110-01-F-D-RA.step
12.7 x 8.31 x 5.71 mm
