davidweber/my_lib/my_3dmodels/ADS1158IRTCT.step

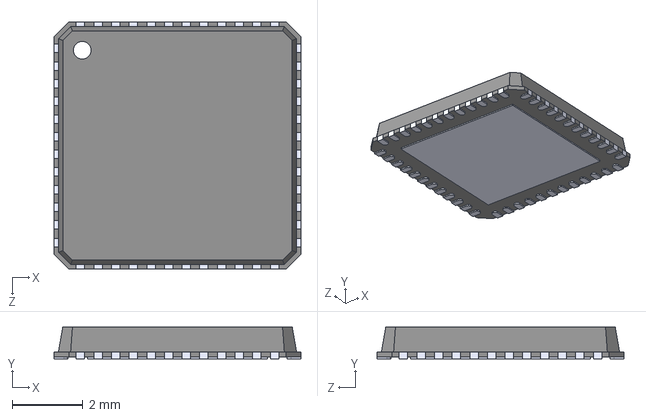
[picture p67: CAD file, 2024-11-12]
my_3dmodels/ADS1158IRTCT.step
7.00 x 0.9 x 7.00 mm
