davidweber/my_lib/my_3dmodels/24AA025UIDT-I_OT.step

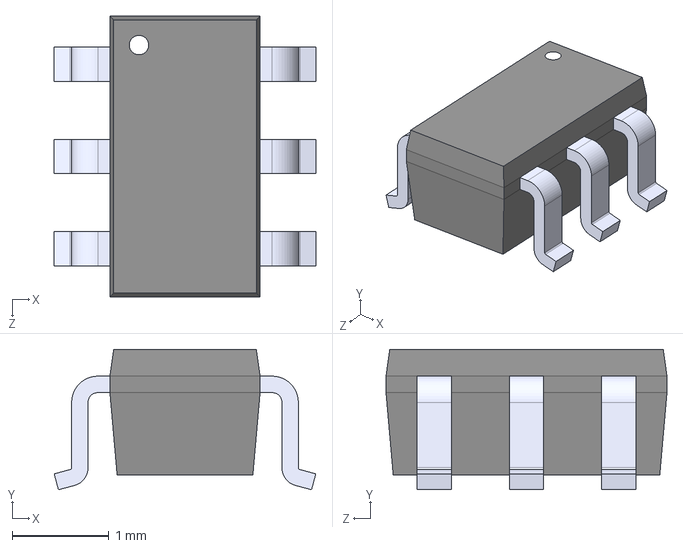
[picture p68: CAD file, 2024-11-12]
my_3dmodels/24AA025UIDT-I_OT.step
2.70 x 1.45 x 2.90 mm
