davidweber/my_lib/my_3dmodels/SOT26.STEP

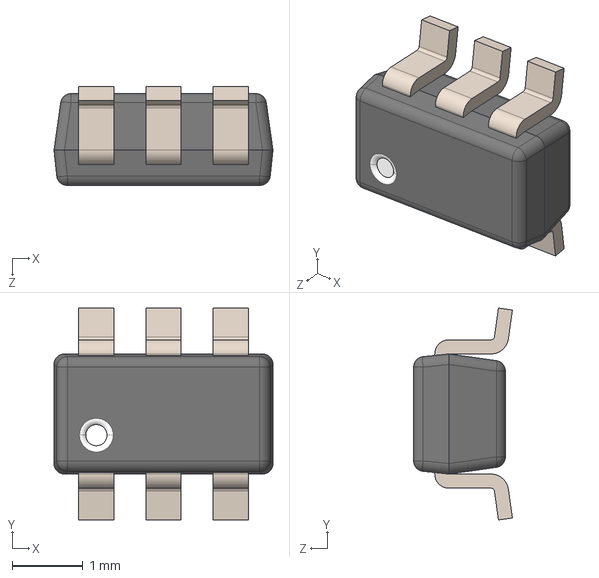
[picture p69: CAD file, 2024-11-12]
my_3dmodels/SOT26.STEP
3.10 x 3.00 x 1.40 mm
