davidweber/my_lib/my_3dmodels/ERJHP6D51R0V.step

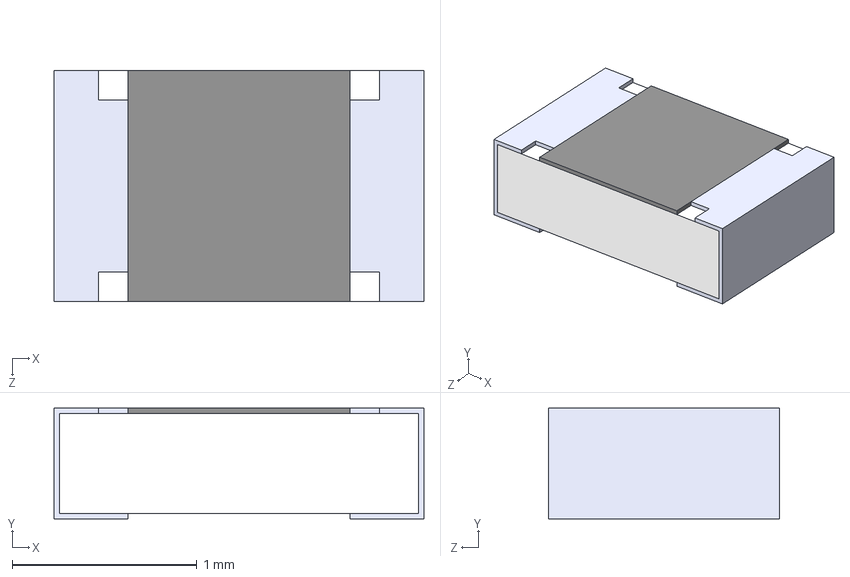
[picture p70: CAD file, 2024-11-12]
my_3dmodels/ERJHP6D51R0V.step
2.00 x 0.6 x 1.25 mm
