davidweber/my_lib/my_3dmodels/USB4105-GF-A-120.step

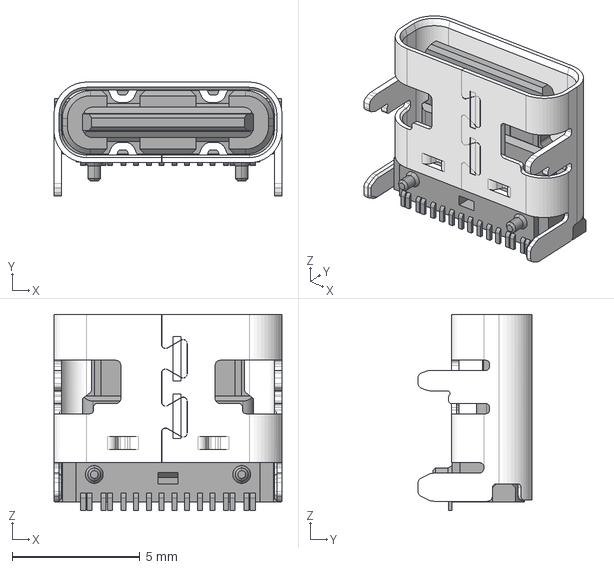
[picture p71: CAD file, 2024-11-12]
my_3dmodels/USB4105-GF-A-120.step
8.94 x 4.46 x 7.70 mm
USB4105-15-A-120_PART2^USB4105-15-A-120(2)_USB4105-15-A-120
USB4105-15-A-120_PART1^USB4105-15-A-120(2)_USB4105-15-A-120
