davidweber/my_lib/my_3dmodels/DFN1006-2.stp

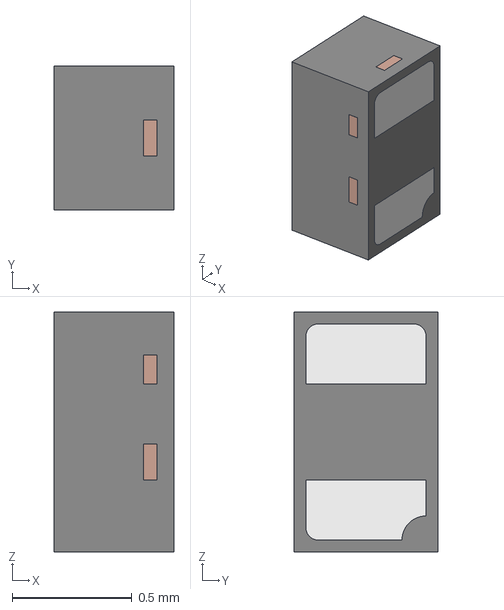
[picture p72: CAD file, 2024-11-12]
my_3dmodels/DFN1006-2.stp
0.5 x 0.6 x 1.00 mm
LDF
