davidweber/my_lib/my_3dmodels/CONN_JST_PH2_SMT.stp

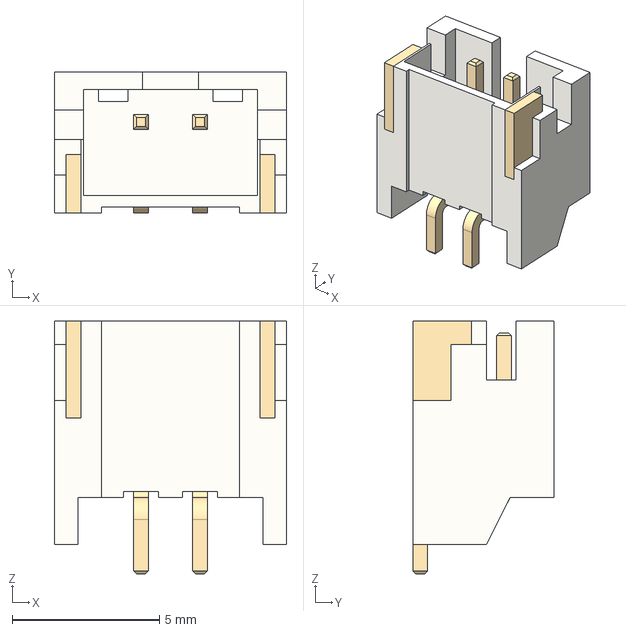
[picture p73: CAD file, 2024-11-12]
my_3dmodels/CONN_JST_PH2_SMT.stp
7.90 x 4.80 x 8.60 mm
