davidweber/my_lib/my_3dmodels/PTS636_SK43_LFS.stp

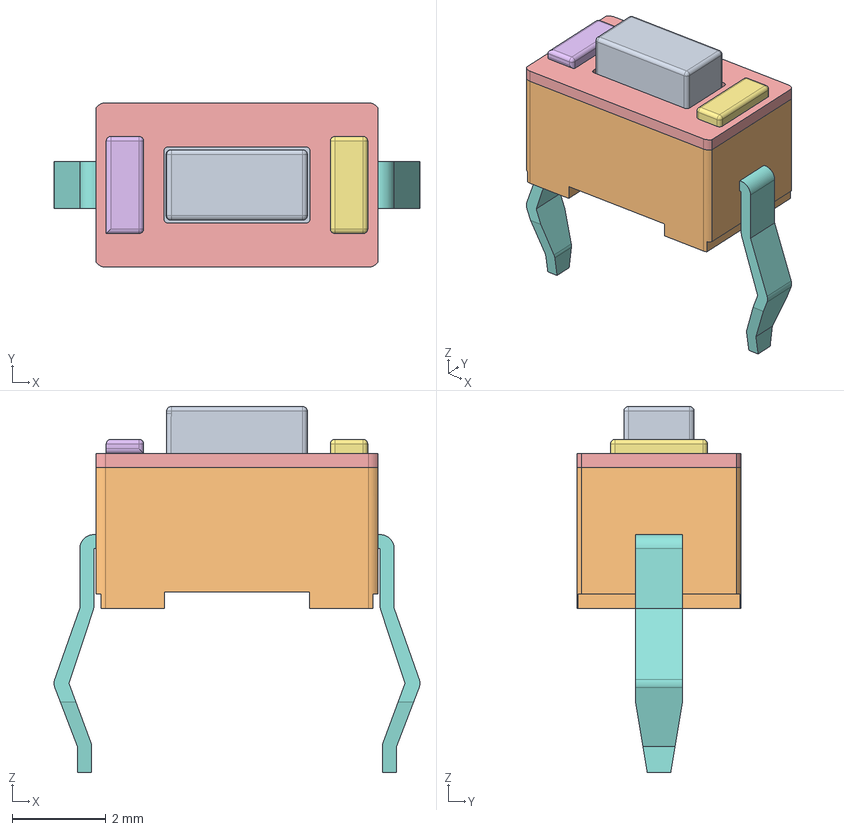
[picture p74: CAD file, 2024-11-12]
my_3dmodels/PTS636_SK43_LFS.stp
7.80 x 3.50 x 7.80 mm
PTS636SK43LFS_PART1
PTS636SK43LFS_PART2
PTS636SK43LFS_PART3
PTS636SK43LFS_PART4
PTS636SK43LFS_PART5
PTS636SK43LFS_PART6
PTS636SK43LFS_PART7
PTS636SK43LFS_PART8
PTS636SK43LFS_PART9
PTS636SK43LFS_PART10
