davidweber/my_lib/my_3dmodels/adms-5050.step

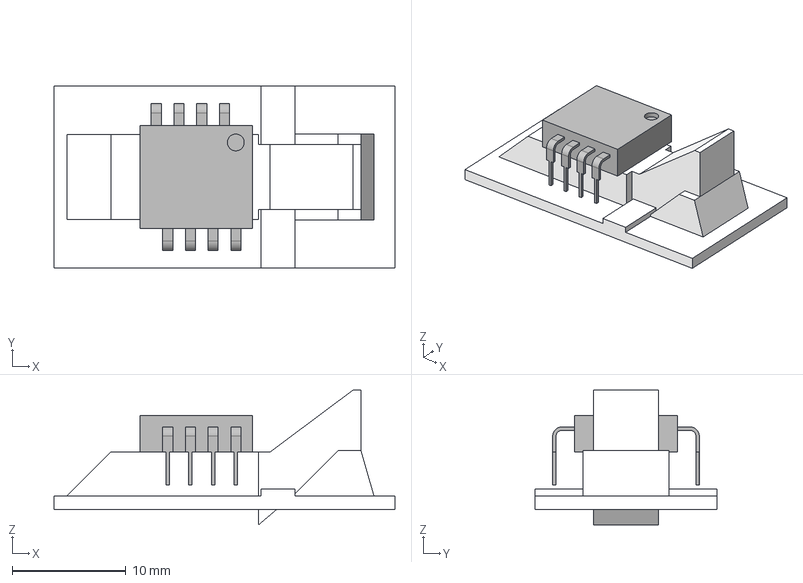
[picture p75: CAD file, 2024-11-12]
my_3dmodels/adms-5050.step
30.0 x 16.0 x 11.8 mm
ADNS-5050
ADNS-5050-Optic
