davidweber/my_lib/my_3dmodels/24AA02UIDT-I_OT.step

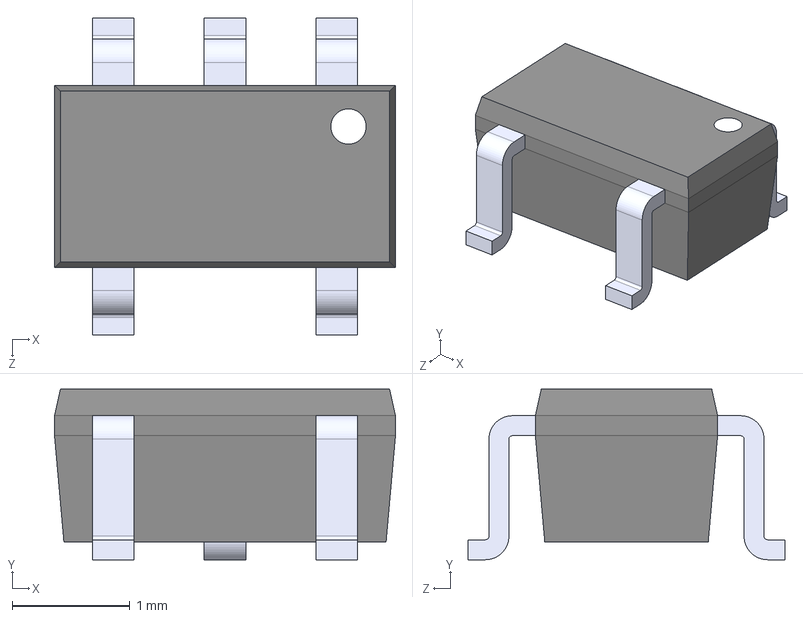
[picture p76: CAD file, 2024-11-12]
my_3dmodels/24AA02UIDT-I_OT.step
2.90 x 1.45 x 2.70 mm
