davidweber/my_lib/my_3dmodels/BLM18PG121SZ1D.stp

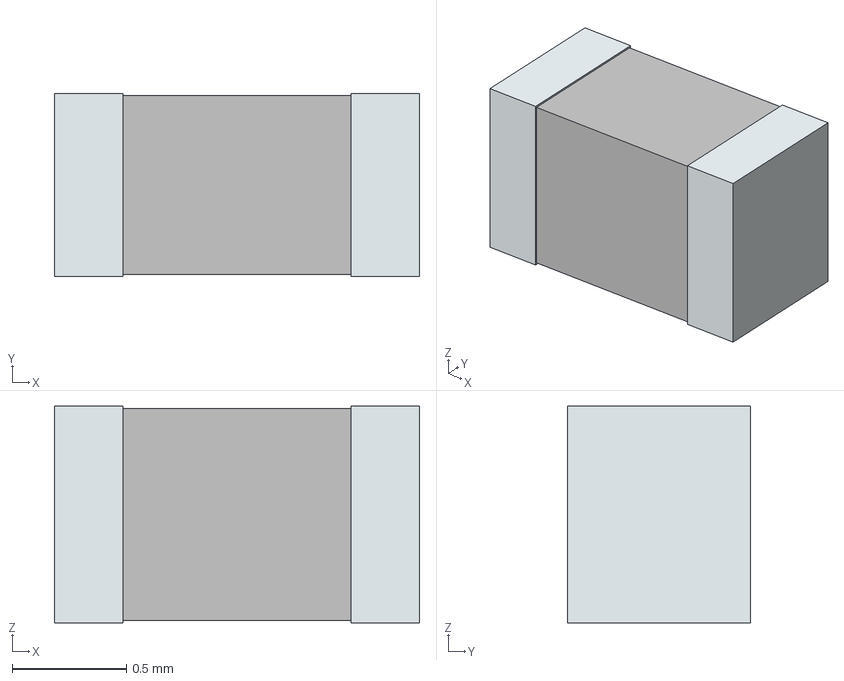
[picture p77: CAD file, 2024-11-12]
my_3dmodels/BLM18PG121SZ1D.stp
1.60 x 0.8 x 0.95 mm
term1
term2
