davidweber/my_lib/my_3dmodels/FTSH-107-01-L-D-RA.step

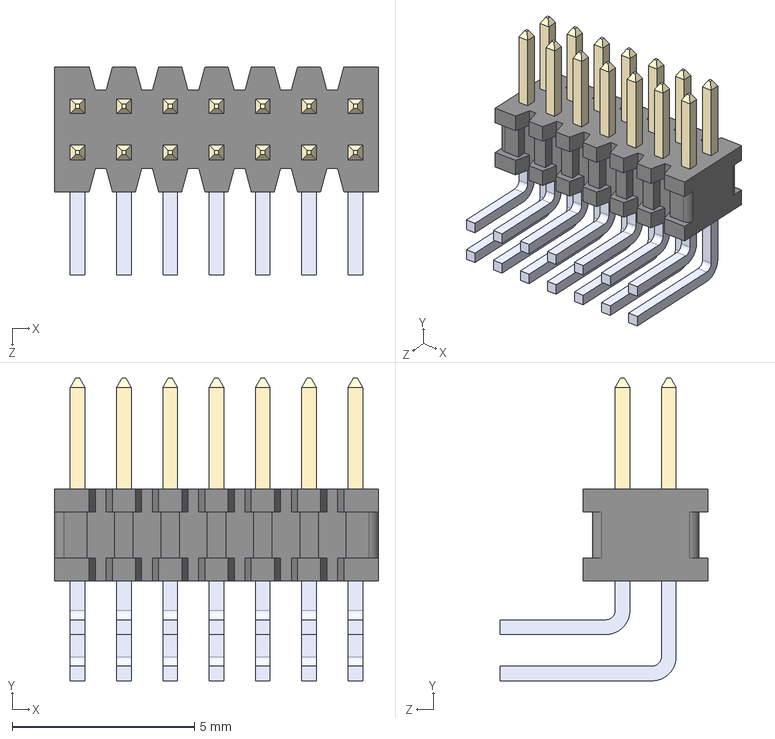
[picture p78: CAD file, 2024-11-12]
my_3dmodels/FTSH-107-01-L-D-RA.step
8.89 x 8.31 x 5.71 mm
