davidweber/my_lib/my_3dmodels/MC74VHC1G03DFT1G.step

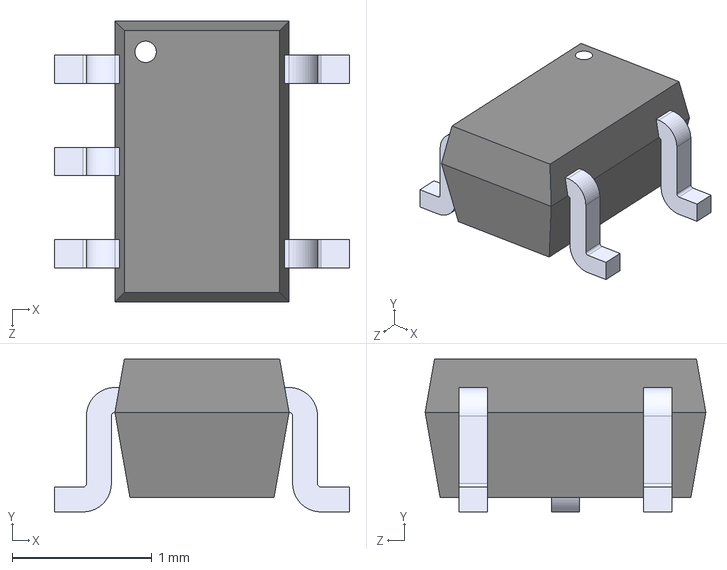
[picture p79: CAD file, 2024-11-12]
my_3dmodels/MC74VHC1G03DFT1G.step
2.11 x 1.09 x 2.01 mm
