davidweber/my_lib/my_3dmodels/TP_THT_loop-red.stp

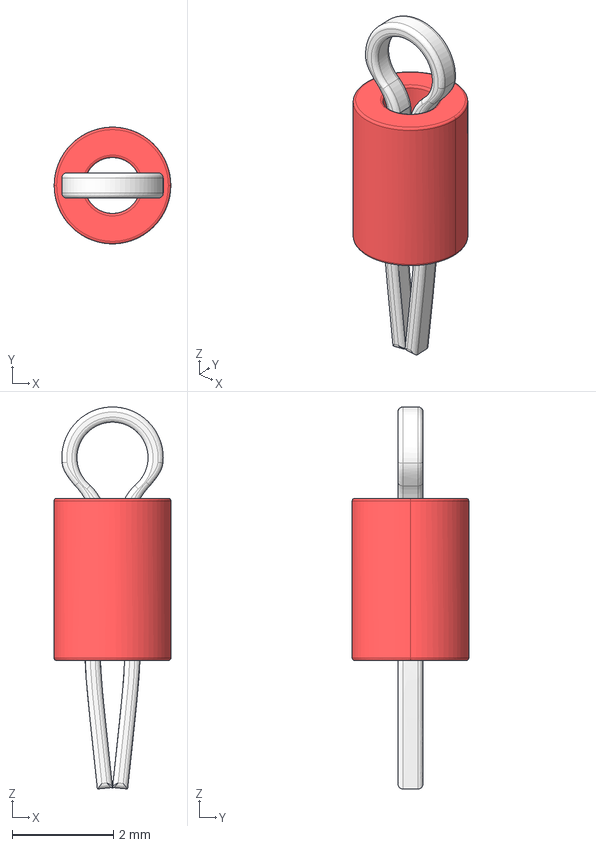
[picture p80: CAD file, 2024-11-12]
my_3dmodels/TP_THT_loop-red.stp
2.30 x 2.30 x 7.53 mm
