davidweber/my_lib/my_3dmodels/POT_1_TURN.step

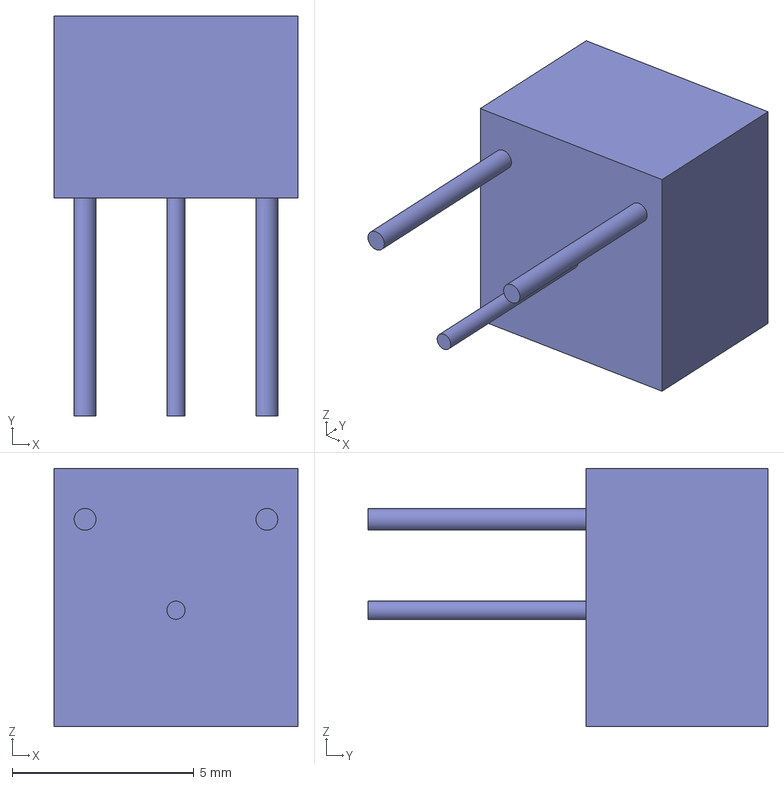
[picture p81: CAD file, 2024-11-12]
my_3dmodels/POT_1_TURN.step
6.70 x 11.0 x 7.10 mm
