davidweber/my_lib/my_3dmodels/Light_Pipe_SLP3-150-150-F.step

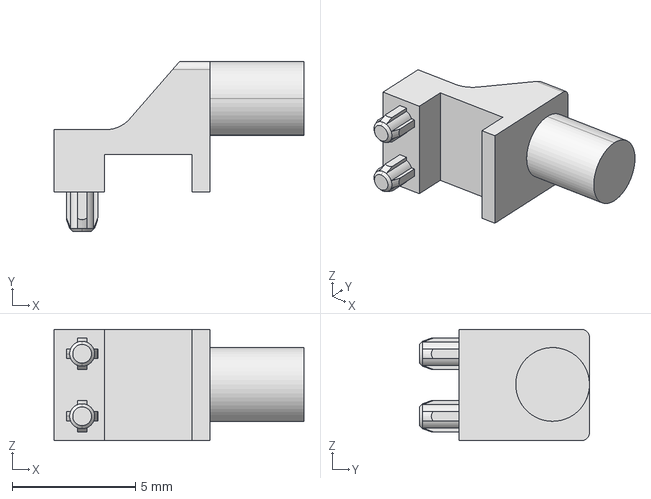
[picture p82: CAD file, 2024-11-12]
my_3dmodels/Light_Pipe_SLP3-150-150-F.step
10.2 x 6.91 x 4.52 mm
