davidweber/my_lib/my_3dmodels/pro-micro-c.step

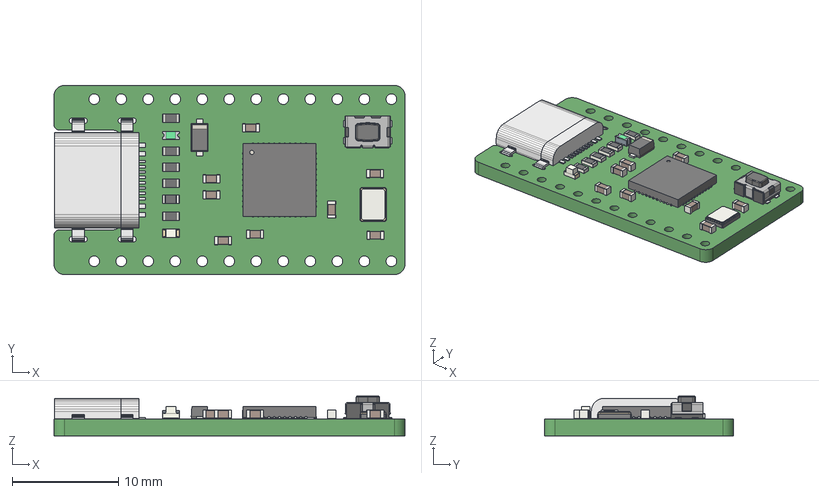
[picture p83: CAD file, 2024-11-12]
my_3dmodels/pro-micro-c.step
33.0 x 17.8 x 3.75 mm
