davidweber/my_lib/my_3dmodels/PTS_647_SM38_SMTR2_LFS.step

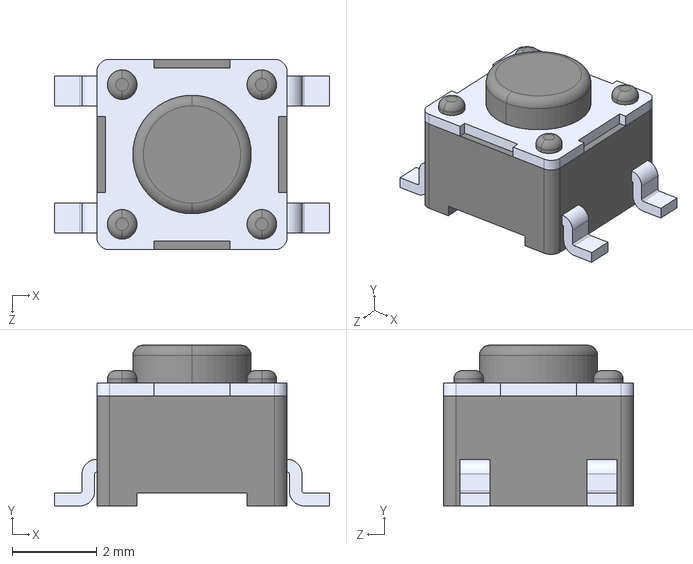
[picture p84: CAD file, 2024-11-12]
my_3dmodels/PTS_647_SM38_SMTR2_LFS.step
6.50 x 3.80 x 4.50 mm
