davidweber/my_lib/my_3dmodels/ERF5-030-07.0-X-DV-FL.step

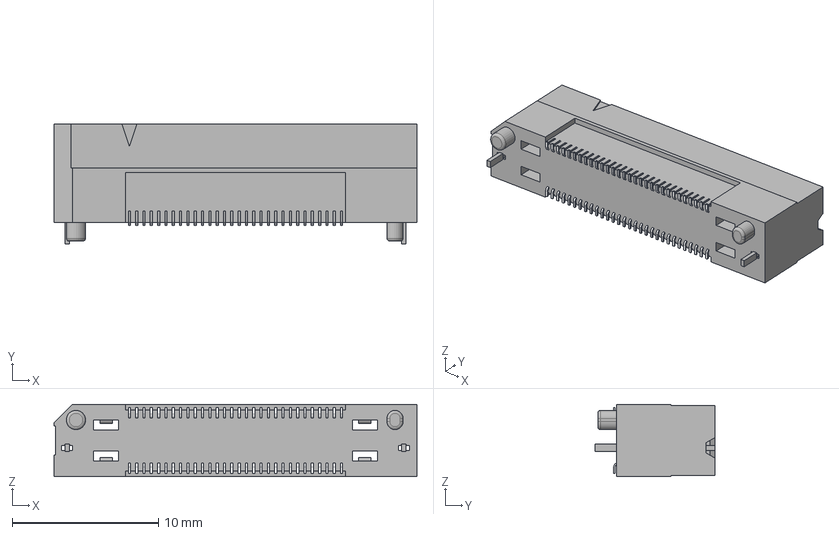
[picture p85: CAD file, 2024-11-12]
my_3dmodels/ERF5-030-07.0-X-DV-FL.step
24.8 x 8.18 x 4.95 mm
ERF5-030-07.0-DV-FL-WT_socket
C-247-030-07.0
C-247-030-07.02
