davidweber/my_lib/my_3dmodels/TL3330AFxxxQG.stp

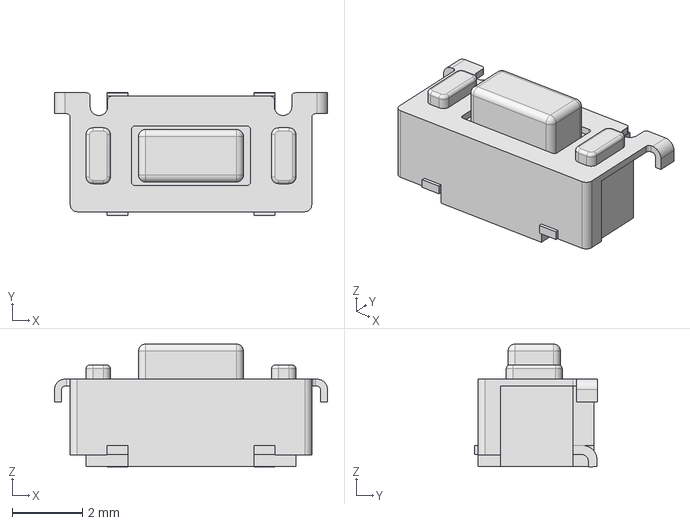
[picture p86: CAD file, 2024-11-12]
my_3dmodels/TL3330AFxxxQG.stp
7.80 x 3.50 x 3.51 mm
