davidweber/my_lib/my_3dmodels/SN65LVDT41PW.step

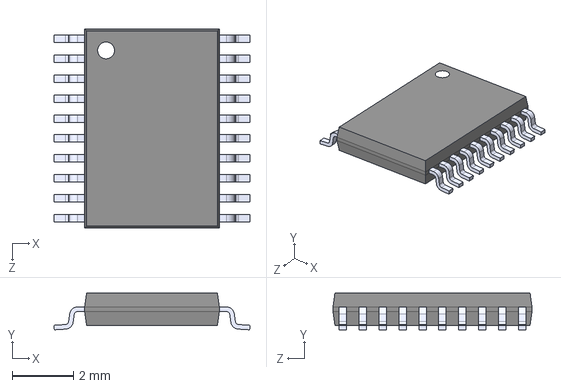
[picture p87: CAD file, 2024-11-12]
my_3dmodels/SN65LVDT41PW.step
6.40 x 1.20 x 6.50 mm
