davidweber/my_lib/my_3dmodels/SAMTEC-LS2-125-01-X-D.step

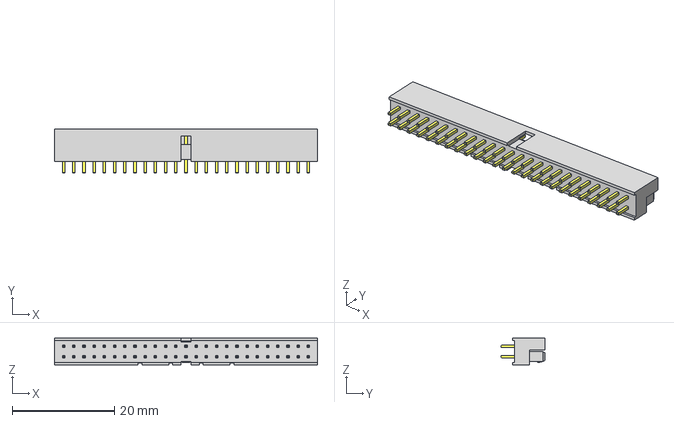
[picture p88: CAD file, 2024-11-12]
my_3dmodels/SAMTEC-LS2-125-01-X-D.step
51.5 x 8.64 x 5.27 mm
LS2-125-01-D_strip
T-1S13-25-01-D
