davidweber/my_lib/my_3dmodels/AP2553FDC-7.step

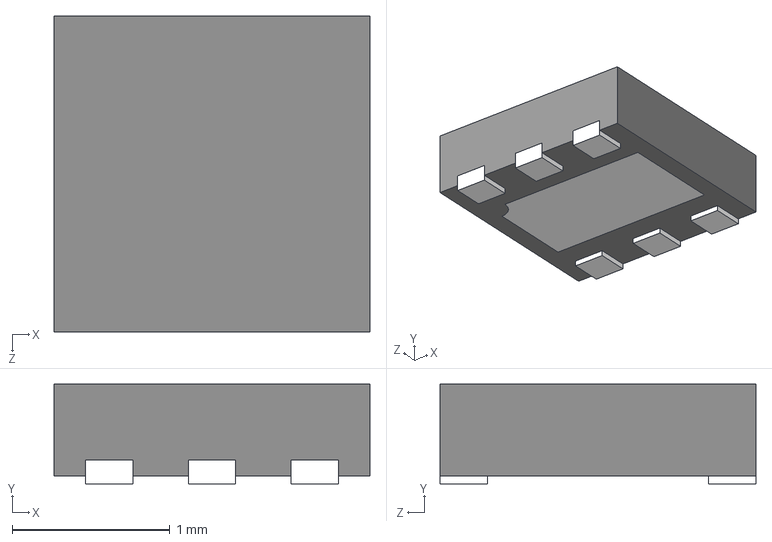
[picture p89: CAD file, 2024-11-12]
my_3dmodels/AP2553FDC-7.step
2.00 x 0.63 x 2.00 mm
