davidweber/my_lib/my_3dmodels/WE-RJ45_7499010121A.step

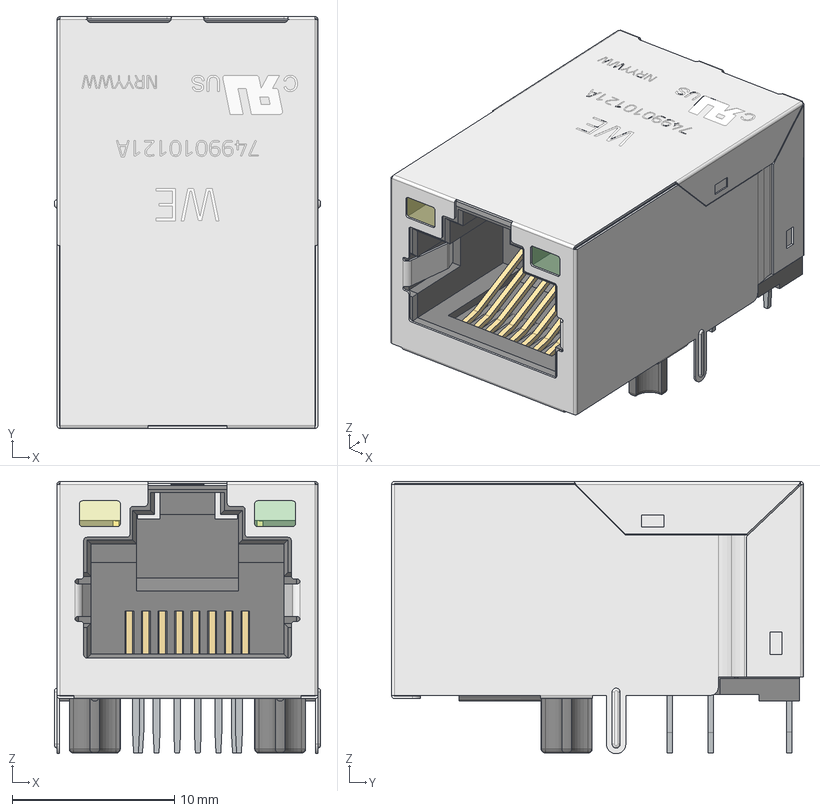
[picture p90: CAD file, 2024-11-12]
my_3dmodels/WE-RJ45_7499010121A.step
16.4 x 25.4 x 16.8 mm
