davidweber/my_lib/my_3dmodels/FTSH-105-01-L-DV-K-TR.stp

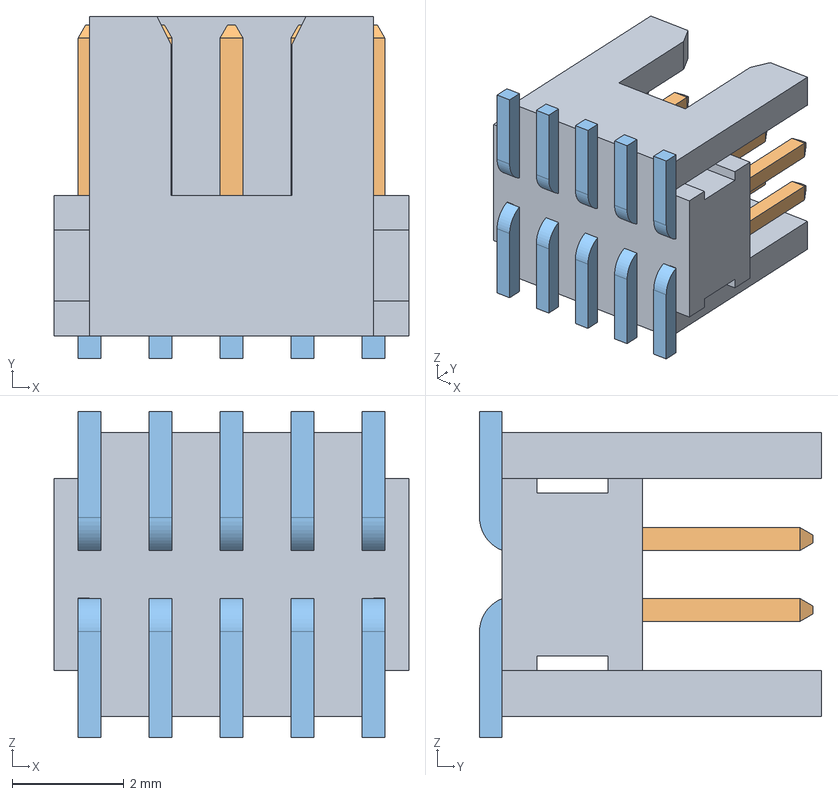
[picture p91: CAD file, 2024-11-12]
my_3dmodels/FTSH-105-01-L-DV-K-TR.stp
6.35 x 6.12 x 5.84 mm
_FTSH-105-01-L-DV-K-TR_body
_FTSH-105-01-L-DV-K-TR_pins1
_FTSH-105-01-L-DV-K-TR_pins2
