davidweber/my_lib/my_3dmodels/TAJB106K025RNJ.step

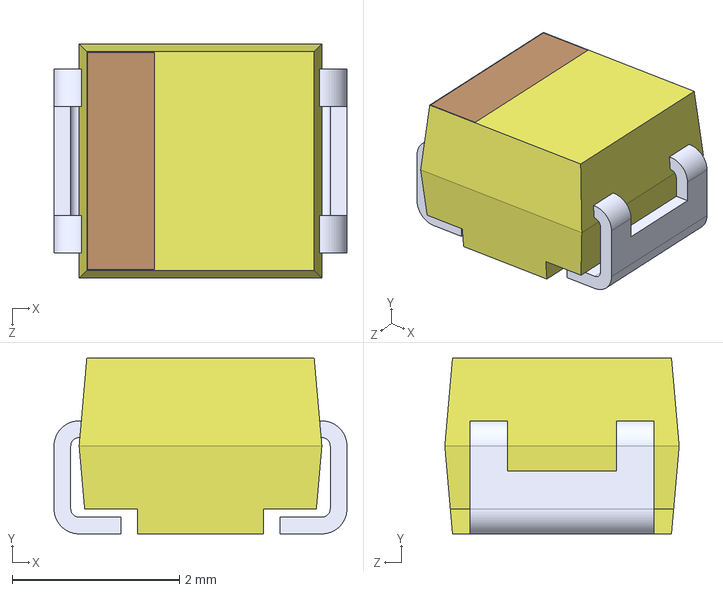
[picture p92: CAD file, 2024-11-12]
my_3dmodels/TAJB106K025RNJ.step
3.50 x 2.10 x 2.80 mm
