davidweber/my_lib/my_3dmodels/ERM5-010-02.0-L-DV-TR.step

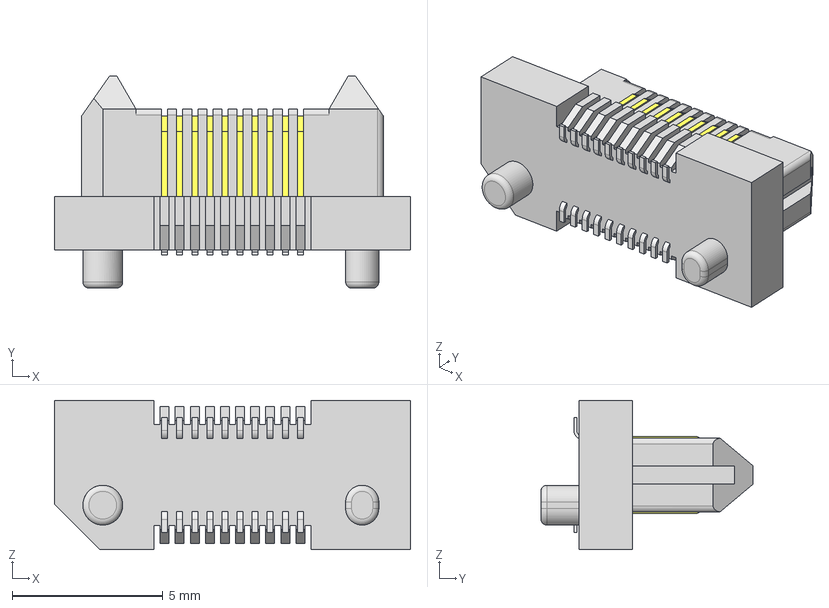
[picture p93: CAD file, 2024-11-12]
my_3dmodels/ERM5-010-02.0-L-DV-TR.step
11.8 x 7.04 x 4.95 mm
ERM5-010-02.0-DV_header
T-1M59-010-02.0
T-1M59-010-02.02
