davidweber/my_lib/my_3dmodels/ec11-encoder.stp

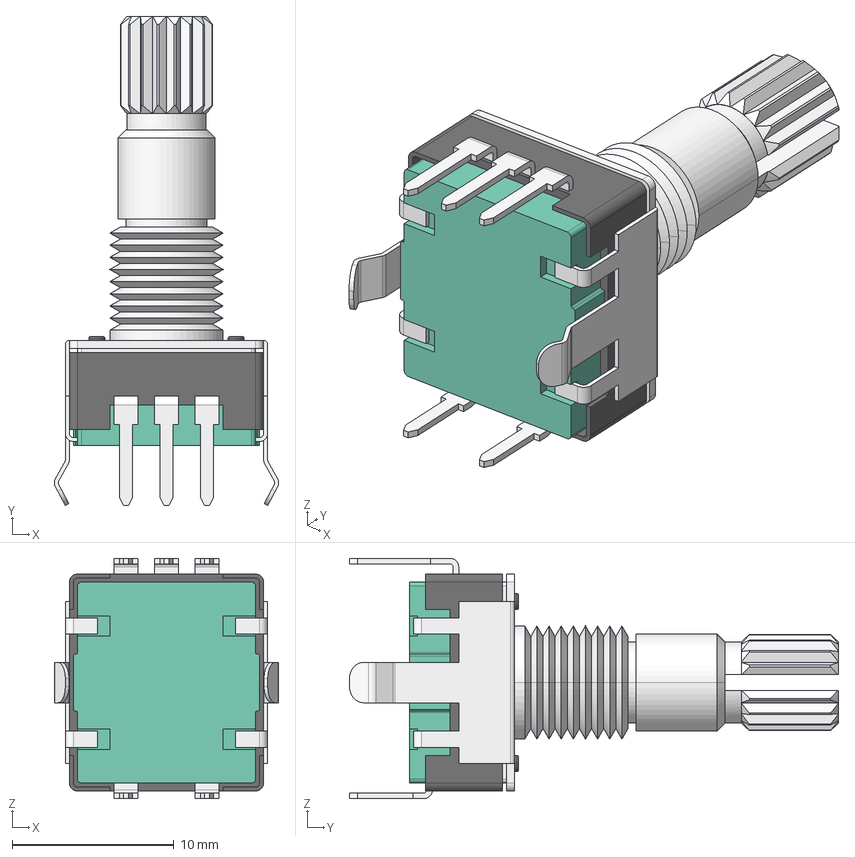
[picture p94: CAD file, 2024-11-12]
my_3dmodels/ec11-encoder.stp
13.9 x 30.2 x 14.8 mm
