davidweber/my_lib/my_3dmodels/LED_WS2812_2020.step

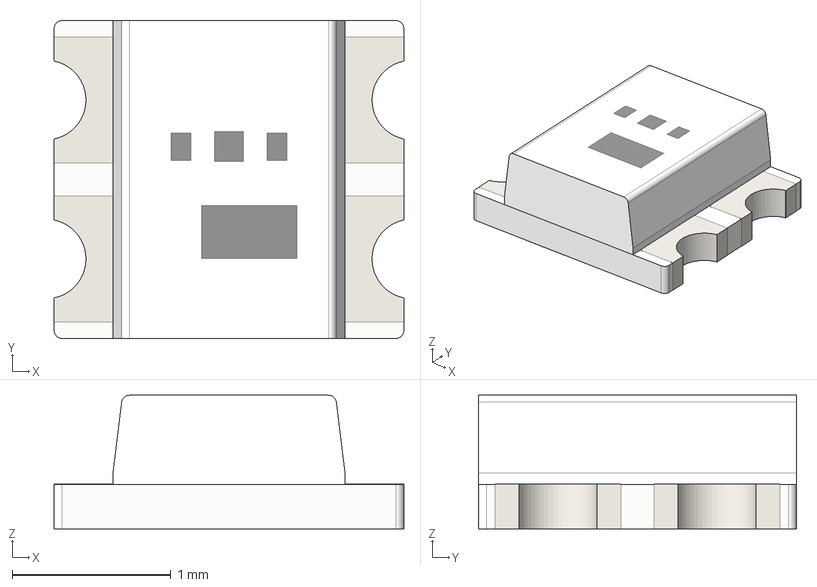
[picture p95: CAD file, 2024-11-12]
my_3dmodels/LED_WS2812_2020.step
2.20 x 2.00 x 0.842 mm
