davidweber/my_lib/my_3dmodels/SN74LVC1G08DBVR.step

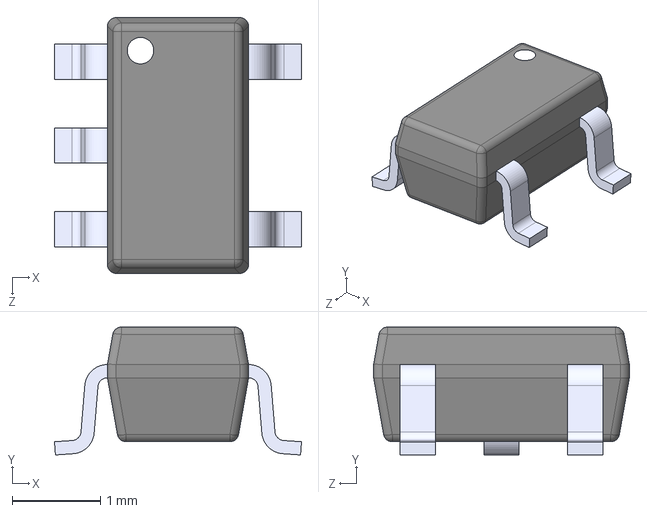
[picture p96: CAD file, 2024-11-12]
my_3dmodels/SN74LVC1G08DBVR.step
2.80 x 1.45 x 2.90 mm
