davidweber/my_lib/my_3dmodels/U262-161N-4BVC11.step

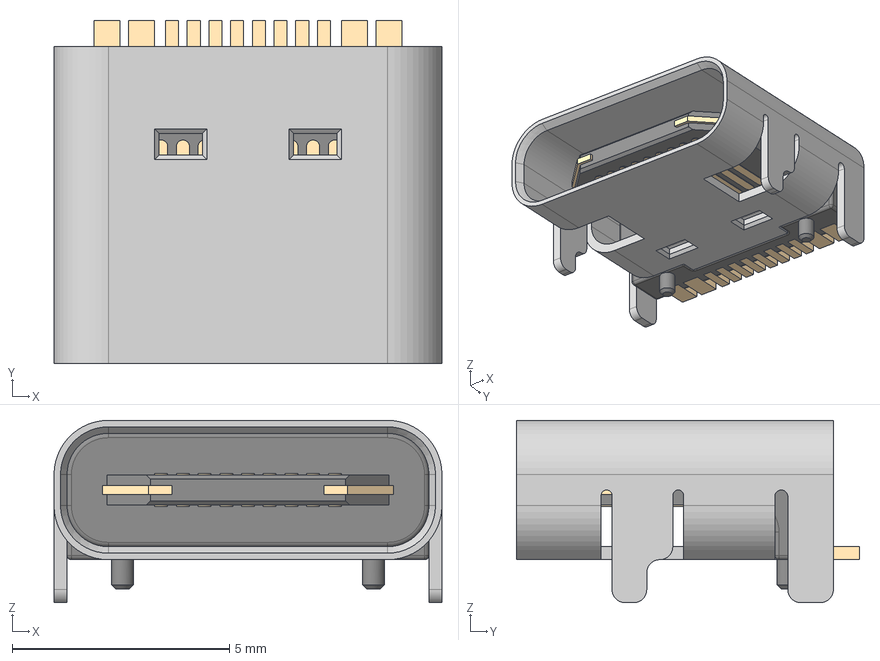
[picture p97: CAD file, 2024-11-12]
my_3dmodels/U262-161N-4BVC11.step
8.94 x 7.90 x 4.20 mm
