davidweber/my_lib/my_3dmodels/ESDALC6V1W5.STEP

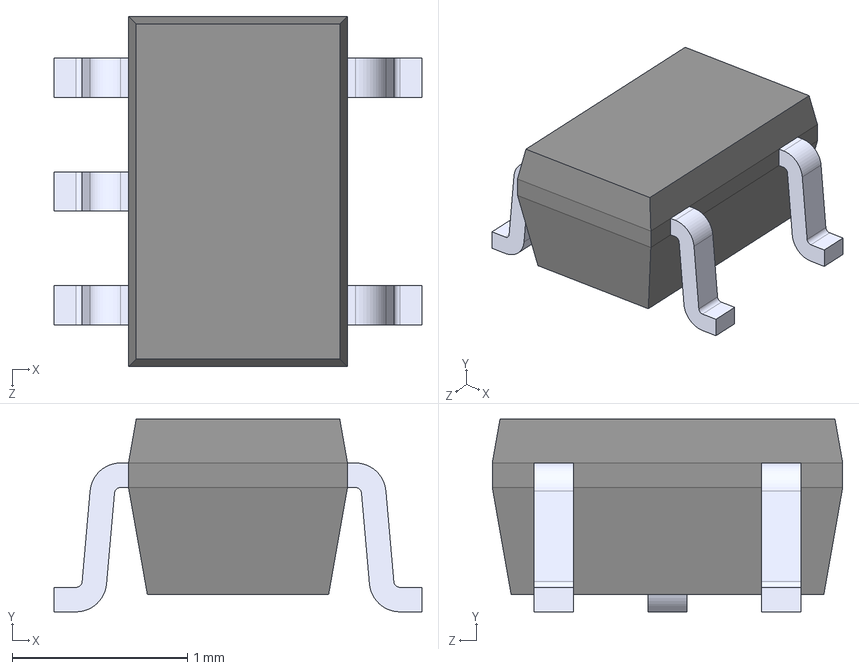
[picture p98: CAD file, 2024-11-12]
my_3dmodels/ESDALC6V1W5.STEP
2.10 x 1.10 x 2.00 mm
