davidweber/my_lib/my_3dmodels/ERJ-UP6D51R0V.step

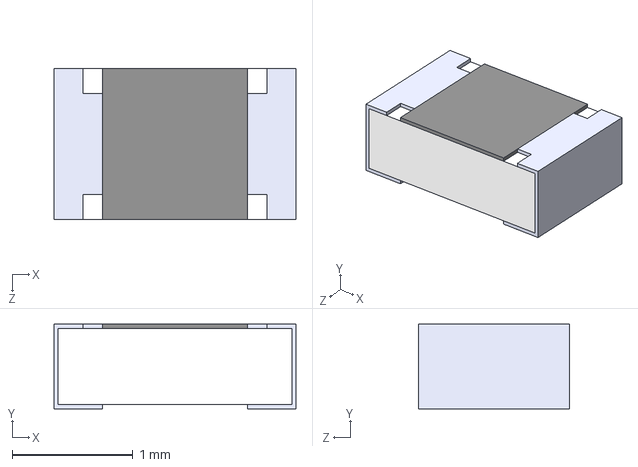
[picture p99: CAD file, 2024-11-12]
my_3dmodels/ERJ-UP6D51R0V.step
2.00 x 0.7 x 1.25 mm
