davidweber/my_lib/my_3dmodels/ERF5-020-05.0-X-DV.step

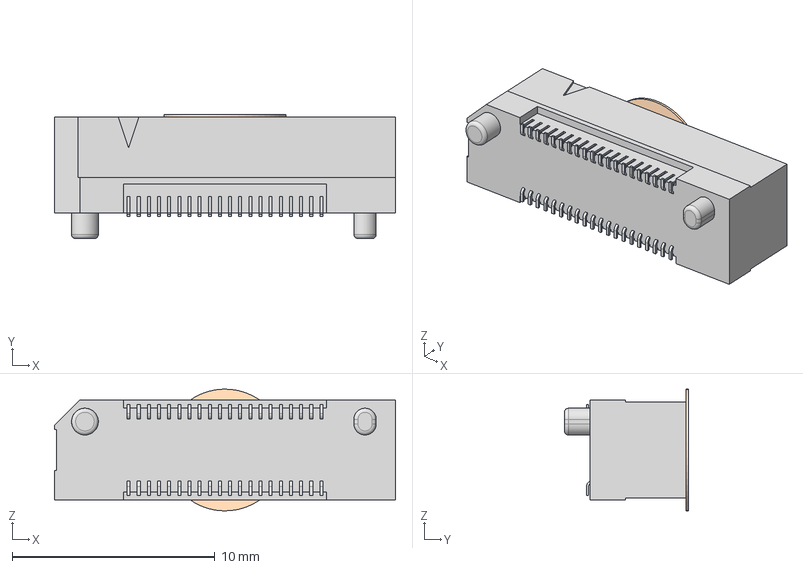
[picture p100: CAD file, 2024-11-12]
my_3dmodels/ERF5-020-05.0-X-DV.step
16.8 x 6.12 x 6.00 mm
ERF5-020-05.0-DV_socket
C-247-020-05.0
C-247-020-05.02
K-DOT-.236-.343-.005_polyamide_pick
