davidweber/my_lib/my_3dmodels/SAMTEC-LS2-110-01-X-D.step

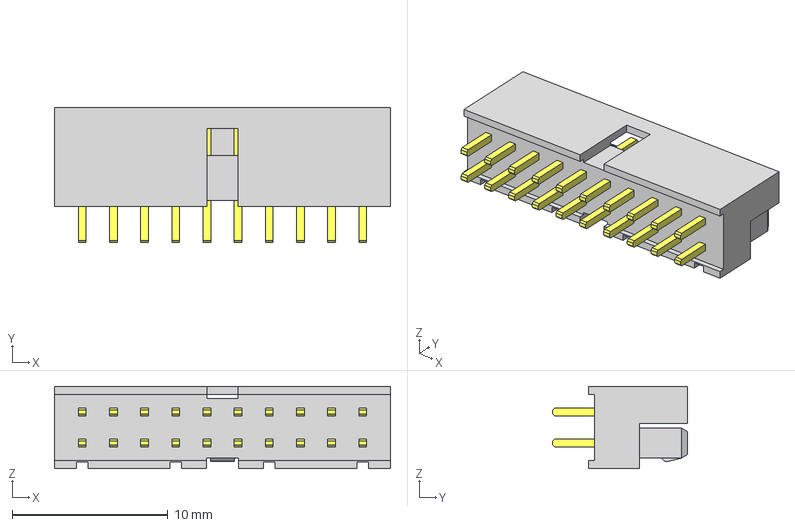
[picture p101: CAD file, 2024-11-12]
my_3dmodels/SAMTEC-LS2-110-01-X-D.step
21.6 x 8.64 x 5.27 mm
LS2-110-01-D_strip
T-1S13-10-01-D
