davidweber/my_lib/my_3dmodels/USBLC6-2SC6.step

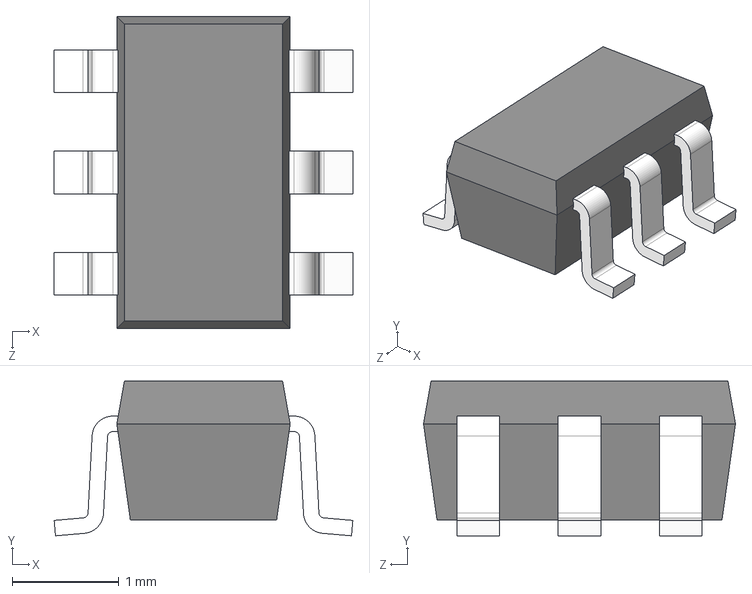
[picture p102: CAD file, 2024-11-12]
my_3dmodels/USBLC6-2SC6.step
2.80 x 1.45 x 2.92 mm
