davidweber/my_lib/my_3dmodels/SAMTEC-LS2-115-01-X-D.step

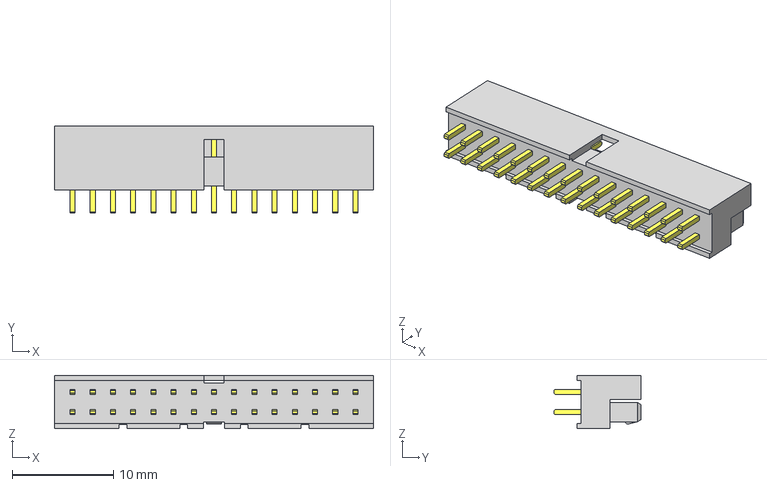
[picture p103: CAD file, 2024-11-12]
my_3dmodels/SAMTEC-LS2-115-01-X-D.step
31.6 x 8.64 x 5.27 mm
LS2-115-01-D_strip
T-1S13-15-01-D
