davidweber/my_lib/my_3dmodels/74LVC125AD.step

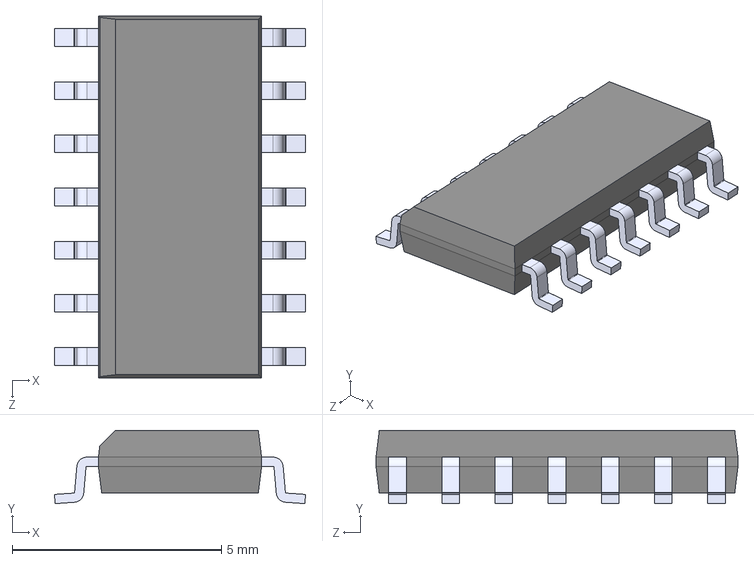
[picture p104: CAD file, 2024-11-12]
my_3dmodels/74LVC125AD.step
6.00 x 1.75 x 8.65 mm
