davidweber/my_lib/my_3dmodels/FOSHAN-FM-B2020RGBA-HG.step

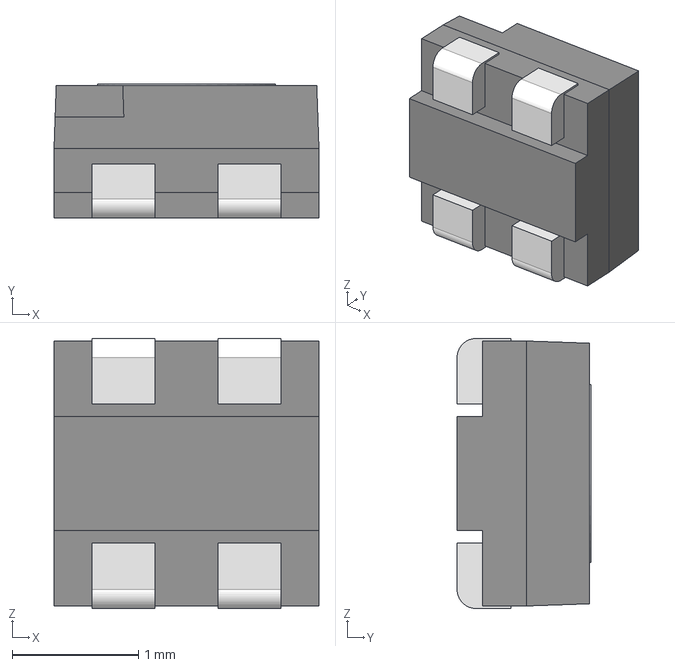
[picture p105: CAD file, 2024-11-12]
my_3dmodels/FOSHAN-FM-B2020RGBA-HG.step
2.10 x 1.06 x 2.14 mm
