davidweber/my_lib/my_3dmodels/Kailh_Hotswap_MX.step

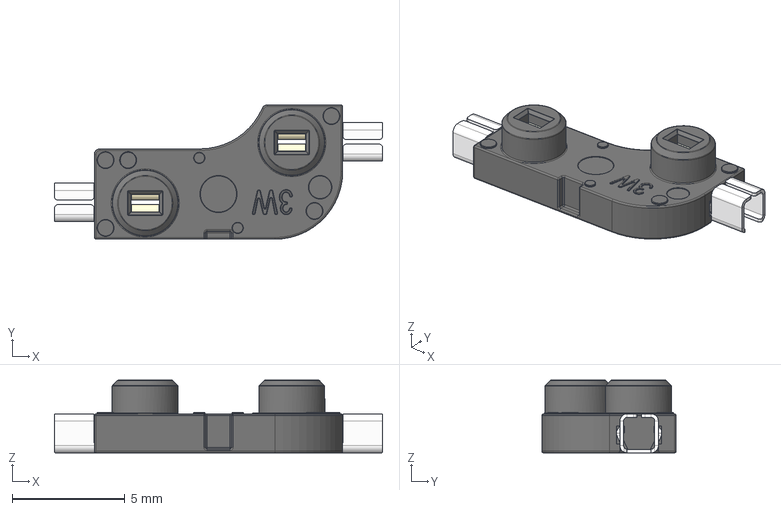
[picture p106: CAD file, 2024-11-12]
my_3dmodels/Kailh_Hotswap_MX.step
14.5 x 5.95 x 3.22 mm
