davidweber/my_lib/my_3dmodels/SMA_CONN_EDGE_MOUNT.step

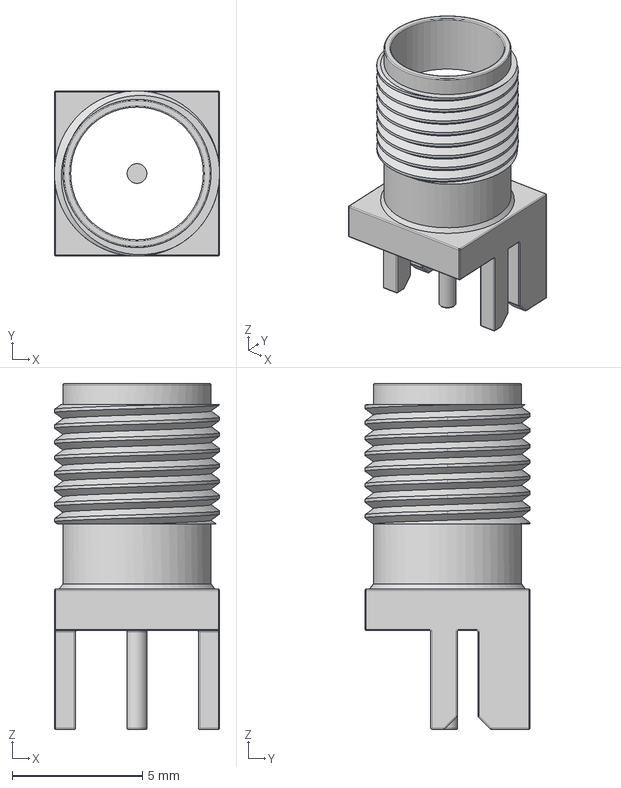
[picture p107: CAD file, 2024-11-12]
my_3dmodels/SMA_CONN_EDGE_MOUNT.step
6.35 x 6.35 x 13.3 mm
