davidweber/my_lib/my_3dmodels/ESDALC6V1-1U2.step

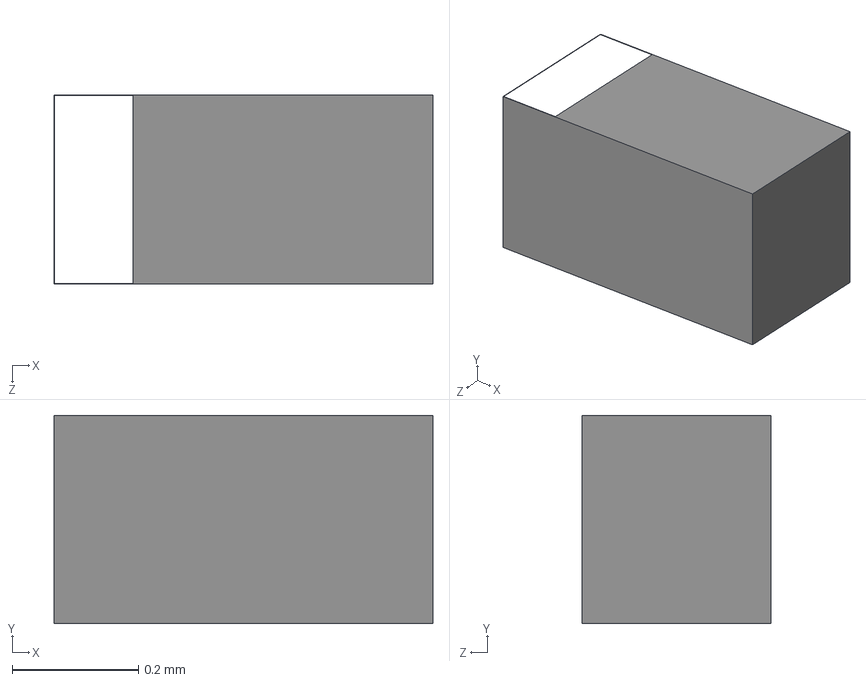
[picture p108: CAD file, 2024-11-12]
my_3dmodels/ESDALC6V1-1U2.step
0.6 x 0.33 x 0.3 mm
