davidweber/my_lib/my_3dmodels/RC2512JK-0751RL.step

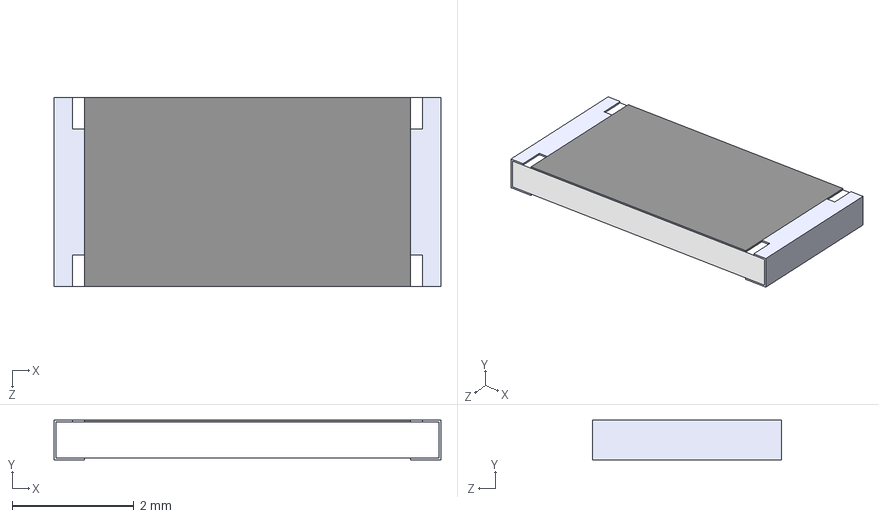
[picture p109: CAD file, 2024-11-12]
my_3dmodels/RC2512JK-0751RL.step
6.35 x 0.65 x 3.10 mm
