davidweber/my_lib/my_3dmodels/MCP601T-I_OT.STEP

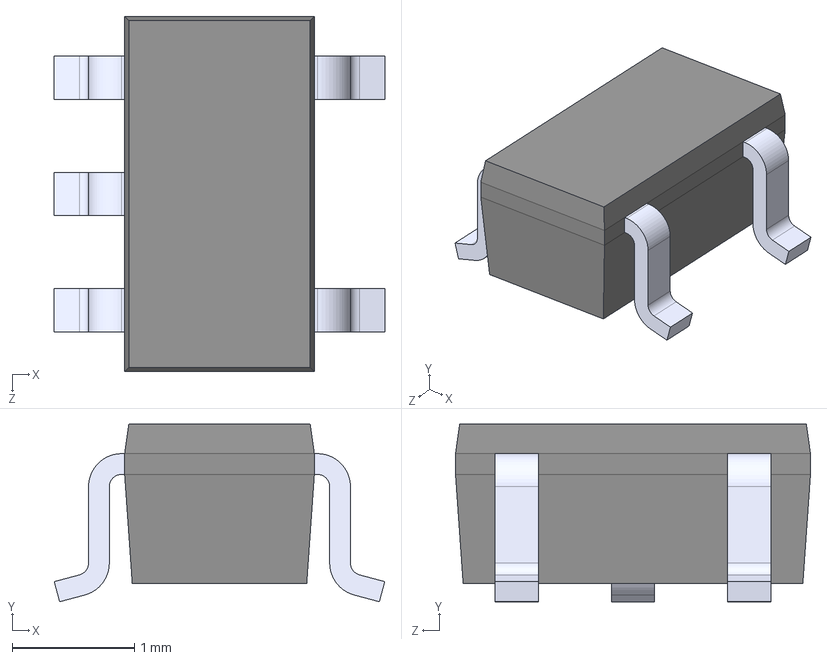
[picture p110: CAD file, 2024-11-12]
my_3dmodels/MCP601T-I_OT.STEP
2.70 x 1.45 x 2.90 mm
