davidweber/my_lib/my_3dmodels/FTSH-110-01-L-D-K.step

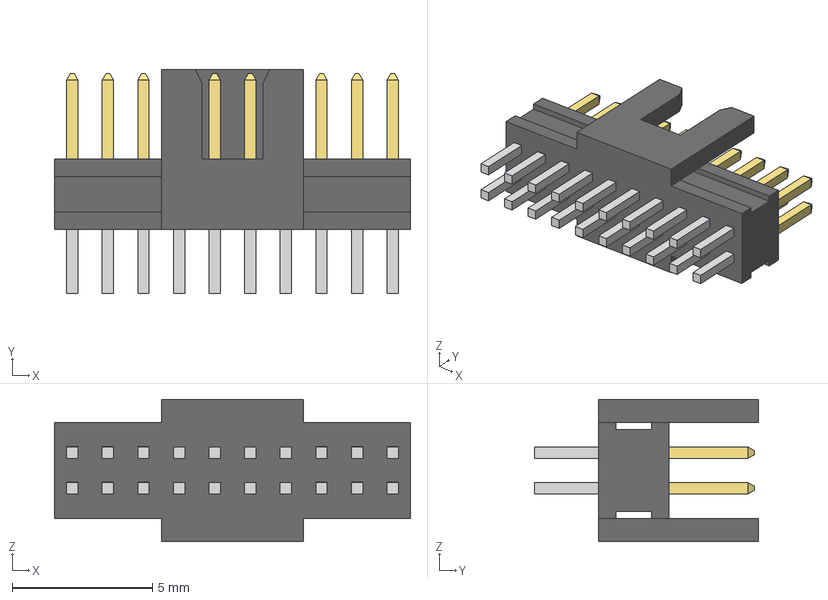
[picture p111: CAD file, 2024-11-12]
my_3dmodels/FTSH-110-01-L-D-K.step
12.7 x 8.00 x 5.08 mm
FTSH-110-01-L-D-K_body
FTSH-110-01-L-D-K_pins1
FTSH-110-01-L-D-K_pins2
