davidweber/my_lib/my_3dmodels/SW_SPDT_PCM12.step

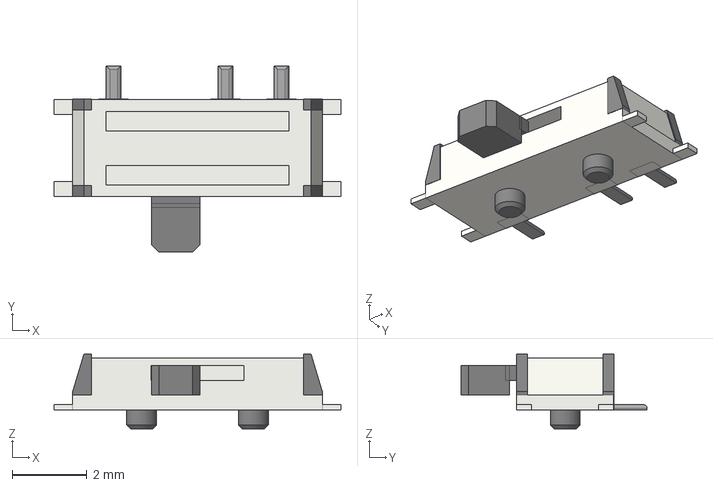
[picture p112: CAD file, 2024-11-12]
my_3dmodels/SW_SPDT_PCM12.step
7.70 x 5.00 x 2.00 mm
