davidweber/my_lib/my_3dmodels/RNH0030A.step

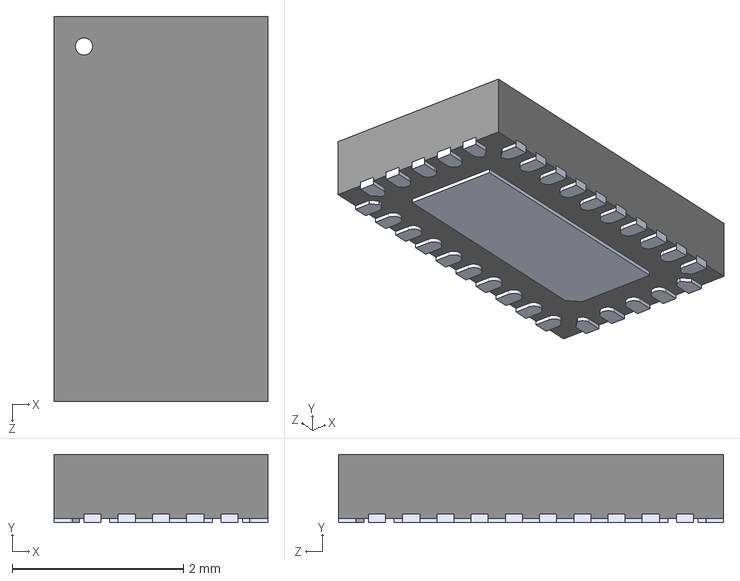
[picture p113: CAD file, 2024-11-12]
my_3dmodels/RNH0030A.step
2.50 x 0.8 x 4.50 mm
