davidweber/my_lib/my_3dmodels/SW_SPDT_JS202011SCQN.stp

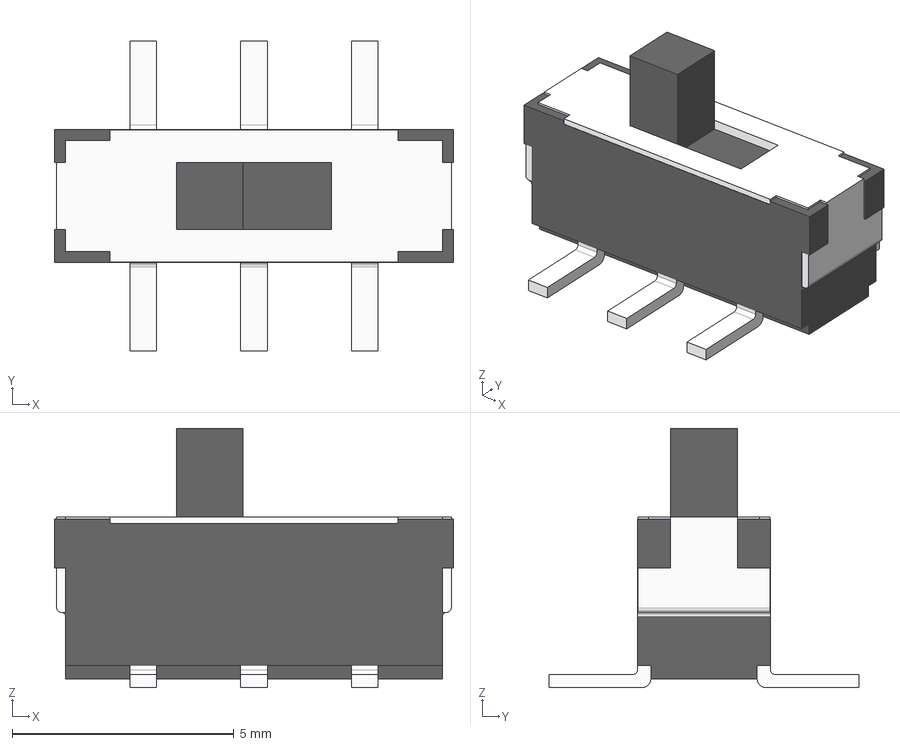
[picture p114: CAD file, 2024-11-12]
my_3dmodels/SW_SPDT_JS202011SCQN.stp
9.00 x 7.00 x 5.85 mm
