davidweber/my_lib/my_3dmodels/SN74LVC3G17DCTR.step

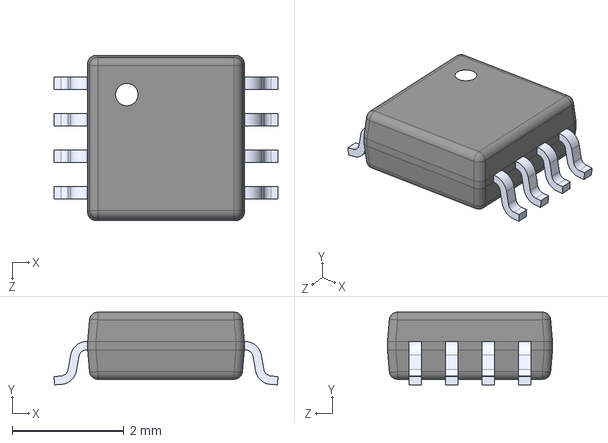
[picture p115: CAD file, 2024-11-12]
my_3dmodels/SN74LVC3G17DCTR.step
4.00 x 1.30 x 2.95 mm
