davidweber/my_lib/my_3dmodels/PTS645.stp

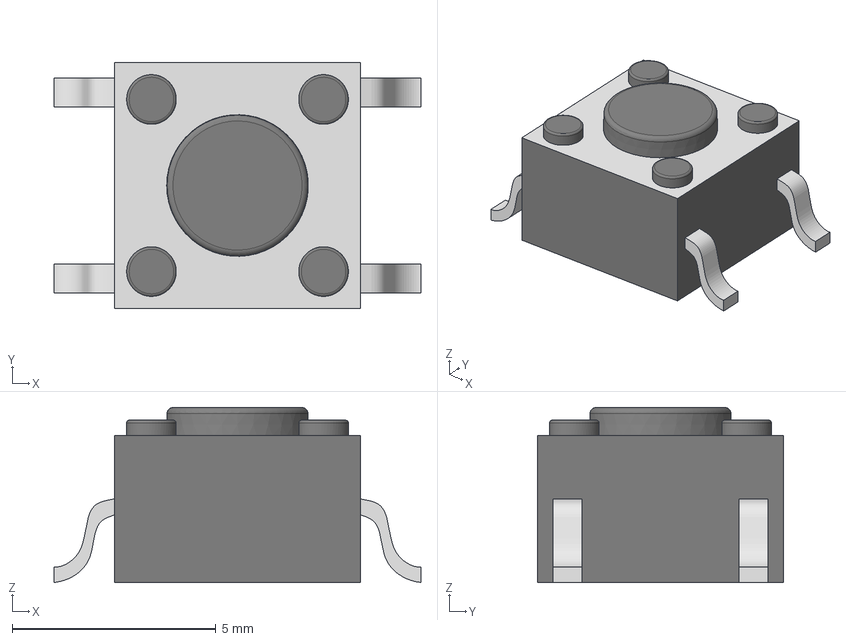
[picture p116: CAD file, 2024-11-12]
my_3dmodels/PTS645.stp
9.02 x 6.03 x 4.30 mm
