davidweber/my_lib/my_3dmodels/lo-a67f.step

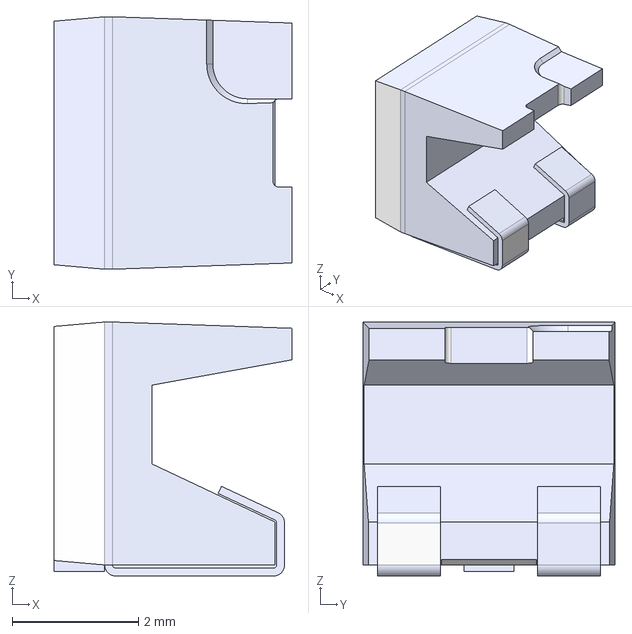
[picture p117: CAD file, 2024-11-12]
my_3dmodels/lo-a67f.step
3.77 x 4.00 x 4.02 mm
LS_A67F_20091130_geometry_RGB15987699 x 2
LS_A67F_20091130_geometry_RGB15987699 (1)
