davidweber/my_lib/my_3dmodels/FTSH-107-01-L-D-K.step

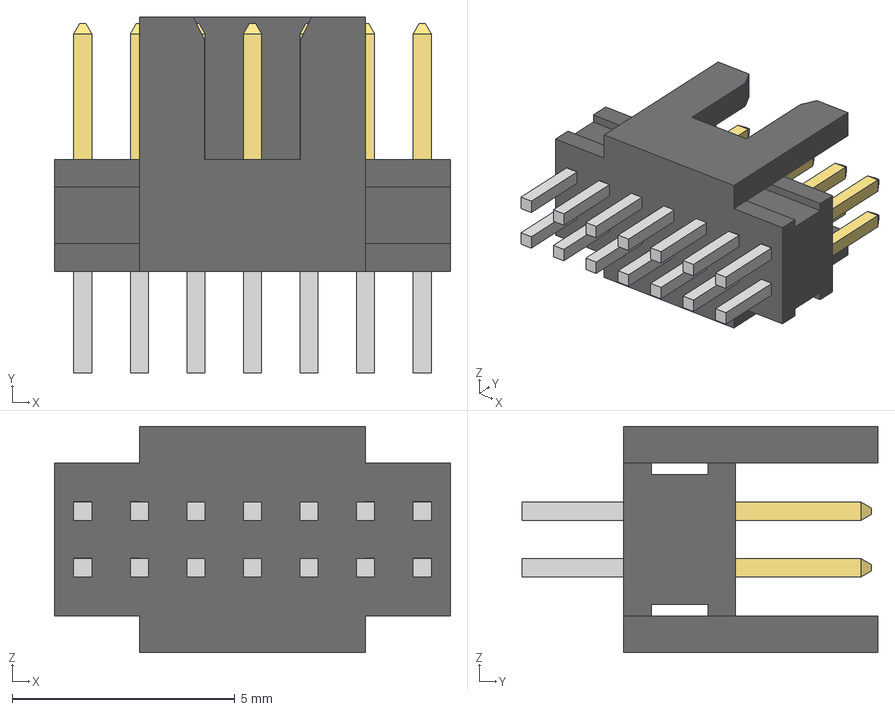
[picture p118: CAD file, 2024-11-12]
my_3dmodels/FTSH-107-01-L-D-K.step
8.89 x 8.00 x 5.08 mm
FTSH-107-01-L-D-K_body
FTSH-107-01-L-D-K_pins1
FTSH-107-01-L-D-K_pins2
