davidweber/my_lib/my_3dmodels/ADS1178IPAPR.step

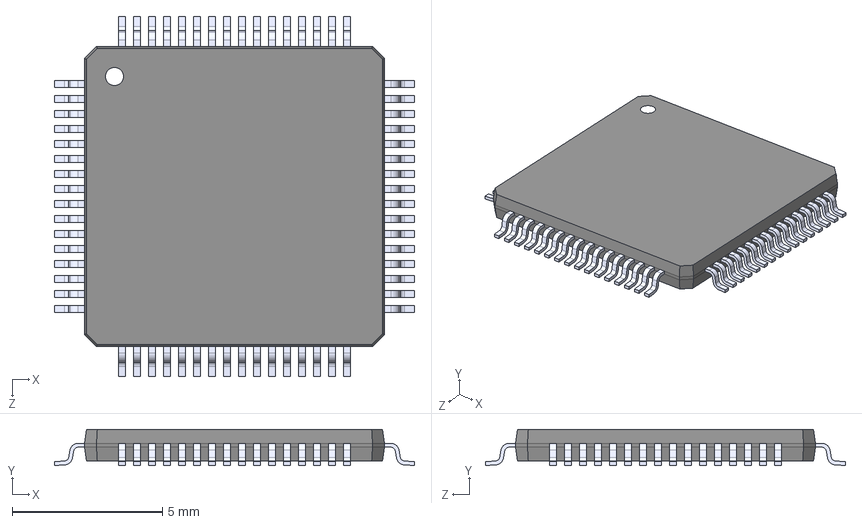
[picture p119: CAD file, 2024-11-12]
my_3dmodels/ADS1178IPAPR.step
12.0 x 1.20 x 12.0 mm
