davidweber/my_lib/my_3dmodels/Mini-Circuits_CD542.step

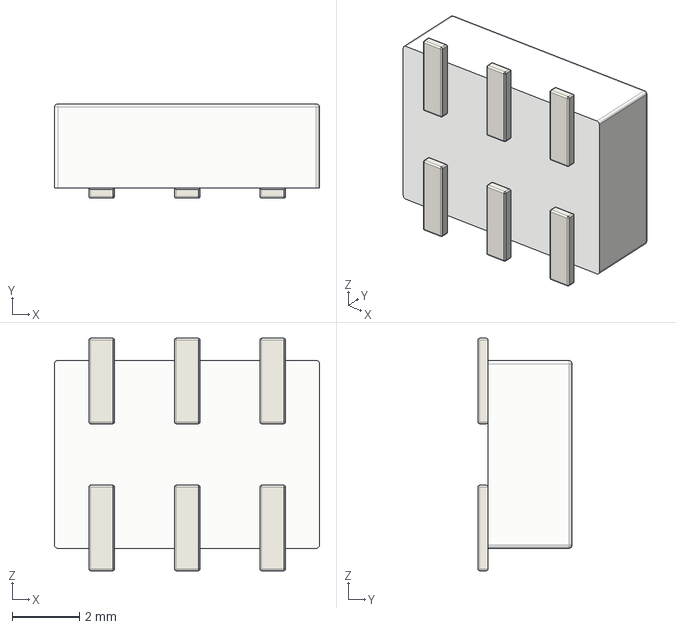
[picture p120: CAD file, 2024-11-12]
my_3dmodels/Mini-Circuits_CD542.step
7.87 x 2.80 x 6.91 mm
