davidweber/my_lib/my_3dmodels/USB4145-03-0070-C.stp

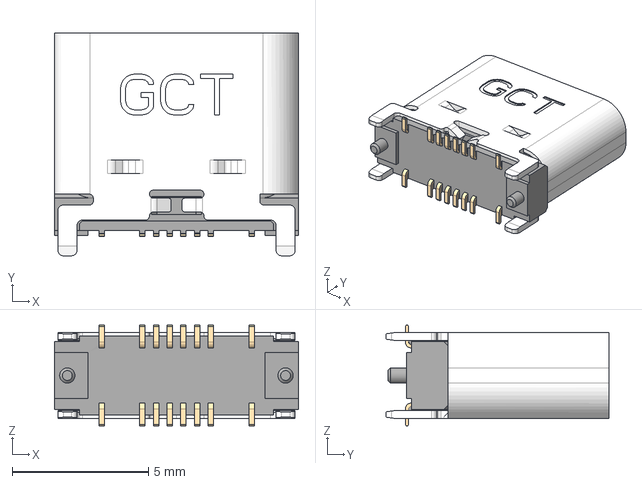
[picture p121: CAD file, 2024-11-12]
my_3dmodels/USB4145-03-0070-C.stp
8.95 x 8.16 x 3.69 mm
USB4145-03-0070-C_PART1
USB4145-03-0070-C_PART2
