davidweber/my_lib/my_3dmodels/D5V0F4U6SO-7.step

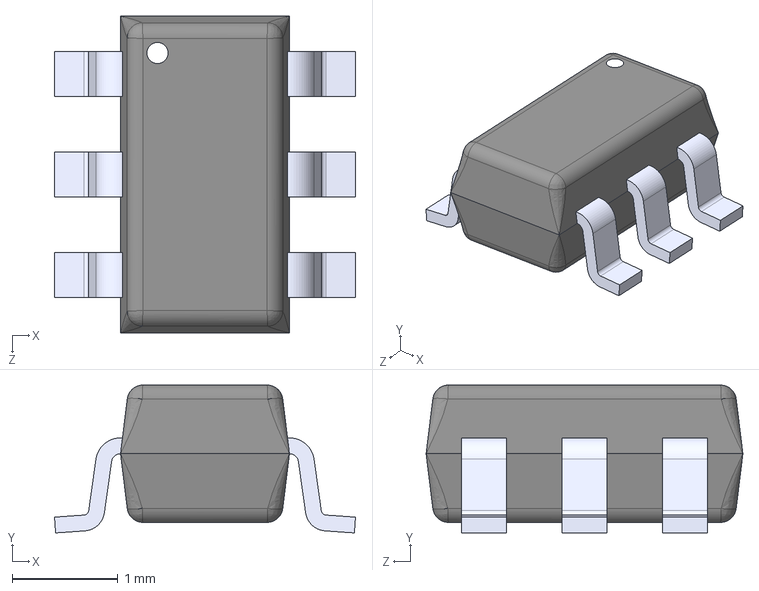
[picture p122: CAD file, 2024-11-12]
my_3dmodels/D5V0F4U6SO-7.step
2.85 x 1.40 x 3.00 mm
