davidweber/my_lib/(list of files, cad)

Other CAD files:
my_3dmodels/ASDMB-16.000MHZ-LY-T.step
my_3dmodels/ASDMB-25.000MHZ-LY-T.step
my_3dmodels/TP_THT_loop_black.stp
my_3dmodels/ASDMB-25.000MHZ-XY-T.step
my_3dmodels/LAN8742AI-CZ-TR.step
my_3dmodels/GCM188L81H104KA57D.step
my_3dmodels/LAN8742-CZ.step
my_3dmodels/0009481024.stp
my_3dmodels/010844032.stp
my_3dmodels/06030-ptc.step
my_3dmodels/10151348-00011LF.step
my_3dmodels/1040310811.stp
my_3dmodels/1054550101.stp
my_3dmodels/150060SS75000.step
my_3dmodels/1724480002.step
my_3dmodels/1825232-1.step
my_3dmodels/20021611-00020T4LF.step
my_3dmodels/2002411116.stp
my_3dmodels/2171750001.step
my_3dmodels/350786-1.step
my_3dmodels/350789-1.step
my_3dmodels/350792-1.step
my_3dmodels/393570003.stp
my_3dmodels/436500215.step
my_3dmodels/436500518.step
my_3dmodels/643406-3.step
my_3dmodels/781710004.stp
my_3dmodels/93463-5206.stp
my_3dmodels/BC02005A02000300LG.STEP
my_3dmodels/M50-3530442.step
my_3dmodels/M50-3530542.step
my_3dmodels/RCS1206120RFKEA.step
my_3dmodels/SOT-26.stp
my_3dmodels/USB4105GFA120.step
