davidweber/my_lib/(commit log)

2024-11-12 add symbol, footprint and 3dmodel files
    [06030-ptc.step, 1.8in TFT (Without Glass)- Tucked Cable.stp, 10151348-00011LF.step, 1040310811.stp, 1054550101.stp, 1267.step, 20021611-00020T4LF.step, 24AA02UIDT-I_OT.step]
2024-11-21 update resistor footprints
2024-11-26 add S4B-PH-K-S_LF__SN
    [S4B-PH-K-S_LF__SN_.step]
2024-12-04 add footprints
2024-12-07 add DS01-254-S-01BE.step
    [DS01-254-S-01BE.step]
2024-12-07 add SW_DS01-254-S-01BE.kicad_mod
2024-12-07 add Header-1x5-2mm-pitch-0.9mm-hole.kicad_mod
2024-12-07 add conn-x1 and DIP switch symbols
2024-12-17 update hole size to .3mm
2024-12-17 add new symbols and footprints
    [010844032.stp, 2002411116.stp]
2025-03-30 remove step file from footprints directory
2025-03-30 fix path to 3-models in kicad_mod files
2025-03-31 add MCP601T-I_OT.STEP and SOD523.step
    [MCP601T-I_OT.STEP, SOD523.step]
2025-03-31 modify 3D layout for SAMTEC-LS2-120-01-X-D footprint
2025-04-03 add TinyTP.kicad_mod
2025-04-07 fix pin number/name problem
2025-04-07 fix pin number/name issues with TinyTP
2025-04-10 add footprint
2025-04-21 add SODFL1608X80N footprint
2025-04-21 TVS diode update
2025-04-23 add xtal oscillator symbol and footprint
2025-04-30 update footprints
2025-04-30 move pin 1 markers and add diode symbols
2025-07-26 add new footprints
2025-07-26 add new 3d models
    [B2B-ZR-SM4-TF--3DModel-STEP-56544.STEP, B5B-ZR-SM4-TF--3DModel-STEP-56544.STEP, B6B-ZR-SM4-TF--3DModel-STEP-56544.STEP, EM2-X-X-X.STEP]
2025-08-11 add MCP9700T-E-TT.STEP file
    [MCP9700T-E_TT.STEP]
2025-08-11 regenerated my_symbols.kicad_sym
2025-08-18 add my_symbols/150060SS75000.kicad_sym my_footprints.pretty/LED_150060SS75000.kicad_mod my_3dmodels/150060SS75000.step
    [150060SS75000.step]
2025-08-18 add WL-SMCW_0603 LED
    [WL-SMCW_0603.step]
2025-09-05 add my_symbols/MCP9700T-E_TT.kicad_sym
2025-09-05 update JST_S2B_PH-K-S_LF__SN_ silkscreen
2025-10-25 add connectors
    [3544.step, B6B-PH-SM4-TB.STEP]
2025-10-25 add my_3dmodels/45F750E.step my_footprints.pretty/DIOAD1300W80L670D310.kicad_mod
    [45F750E.step]
2025-10-25 add my_footprints.pretty/SD1206_AVX.kicad_mod my_symbols/SD1206-AVX.kicad_sym
2025-10-25 add my_3dmodels/0009481024.stp my_footprints.pretty/0009481024.kicad_mod my_symbols/09481024.kicad_sym
    [0009481024.stp]
2025-10-25 edit my_footprints.pretty/FUSE_3544.kicad_mod
2025-10-25 add my_3dmodels/RCS1206120RFKEA.step add my_footprints.pretty/RESC3116X65N.kicad_mod my_symbols/RCS1206120RFKEA.kicad_sym
    [RCS1206120RFKEA.step]
2026-03-04 add MBRD660CTG part
    [MBRD660CTG.STEP]
2026-04-10 add new components
    [2171750001.step, CONMHF1-SMD-G-T.step, L8BE-1G1T-BFH.step]
2026-04-10 update my_symbols.kicad_sym lib
2026-04-15 modify footprint for LINX_CONMHF1-SMD-G-T connector
2026-04-23 add ASDMB-50 oscillator
    [ASDMB-50.000MHZ-XY-T.step]
2026-05-01 add symbols for ESP32-S3-MINI-1-N8
    [ESP32-S3-MINI-1-N8.step]
2026-05-08 add WIZ-IP55 footprint
2026-05-08 add ESP32-S3 footprint
2026-08-18 add step files
    [ABM8-16.384MHZ-10-1-U-T.step, ADS131M08IPBS.step, ASV-16.384MHZ-EJ-T.step, SN74HCS365QWBQBRQ1.step, YC124-FR-071KL.step, YC164-FR-071KL.step]
2026-08-25 update 40 SAMTEC connector soldermask
2026-08-25 add resistor pack, capacitor, EEPROM, temp/humidity sensor
