davidweber/my_lib/(notices)

Notices in the files:
my_3dmodels/ERM5-030-02.0-S-DV-TR.step:
author */ ('License CC BY-ND 4.0'),
